jdennis011/haltech-gauges/README.md

# Haltech gauges

Round digital gauges for a car running a Haltech Nexus ECU. A hub listens to the
Haltech CAN broadcast, bridges the frames the gauges use to a private gauge bus
(`docs/frame-filter.md`), and hosts a web page for
setting the gauges up. One to three Waveshare ESP32-S3-Touch-AMOLED-1.75 gauges hang off
the hub on a daisy chain of 5 V and CAN, each on a small adapter board.

- Hub: ESP32-C6 (two CAN controllers plus Wi-Fi) on a carrier board. A Lolin C3 Mini runs
  the hub firmware for development, minus the ECU bridge.
- Gauge: the Waveshare board with an adapter that supplies power and CAN. An M5Stack Dial
  stands in on the bench.
- Faces are JSON configs: dials, rings, bars, numbers, labels, warning lights and shift
  rims, in a choice of fonts and themes. Fifteen starter templates are built in.
- The hub's page previews faces, pushes configs to gauges, and lets gauges be planned
  before the hardware exists. A visual designer is planned (`docs/designer-plan.md`).

## Building

PlatformIO with the pioarduino platform (installed on first build into its own core
directory, leaving a stock PlatformIO install alone).

```
pio run -e hub            # ESP32-C6 hub
pio run -e hub_dev_c3     # Lolin C3 Mini development hub
pio run -e gauge          # Waveshare gauge
pio run -e gauge_m5dial   # M5Stack Dial as a gauge
pio run -e wheel          # steering wheel module (Lolin C3 Mini)
pio test -e native        # host unit tests (scripts/test.ps1 finds a g++ on Windows)
node scripts/check_page.js # the hub page's script: syntax, and no function declared twice
.\scripts\release_fw.ps1  # publish hub builds on the site for updates over Wi-Fi
```

The hub's web page, templates and fonts are embedded into the firmware by
`scripts/embed_web.py` before each hub build.

## Online copy

**https://oagauge.online** (also at https://haltech-gauges.jdennis011.workers.dev)

The same page runs on Cloudflare without a hub, in demo mode: every template, font and
channel is there, previews animate, and what you make stays in your browser. Export a
config there and import it on your hub's page.

```
npm install          # once: wrangler
npm run build        # assembles ./dist from web/, assets/ and web/data/channels.json
npm run dev          # serves it at http://127.0.0.1:8787
npm run deploy       # publishes the Worker (wrangler login first)
```

`worker/index.js` serves the built files and answers the hub's data paths from static
files. It also handles **Sign in with Google** and keeps a signed-in user's configs,
planned gauges, assignments and recordings in a KV namespace, behind the hub's own API
paths, so work follows the account across devices. Signed out, the page keeps its work in
the browser.

To enable sign-in: in Google Cloud Console, APIs & Services, Credentials, create an
OAuth client ID of type Web application with the site's addresses as authorised
JavaScript origins (`https://oagauge.online`, `https://www.oagauge.online` and the `workers.dev` address); put the
client ID in `wrangler.jsonc` under `vars.GOOGLE_CLIENT_ID` and deploy. The session
secret is a Worker secret (`wrangler secret put SESSION_SECRET`), and local runs read it
from `.dev.vars`. `scripts/gen_channels.ps1` regenerates `web/data/channels.json` from the firmware's
channel tables; run it when `haltech_channels.def` or `units.cpp` change. Cloudflare's
Workers Builds can run `npm run build` and deploy on every push to `main`.

## Documents

| | |
|---|---|
| `docs/web-ui.md` | The hub's page and its REST and WebSocket API |
| `docs/config-schema.md` | The face config format |
| `docs/templates.md` | The built-in templates, with a gallery |
| `docs/alerts.md` | Alerts: rules on the hub that put a message on the gauges, or switch them to another config or face, when a channel meets a condition |
| `docs/images.md` | Images for the faces: kept on the hub, sent to each gauge once, over the gauge bus or, for big ones, the hub's Wi-Fi |
| `docs/cloud-sync.md` | Linking a hub to an account on the online copy, so configs, images, theme colours and alerts stay in step both ways |
| `docs/firmware-updates.md` | Firmware updates over Wi-Fi: a script that publishes builds on the site, the hub's check and install with rollback, a `.bin` upload from the page, and gauge builds passed on by the hub |
| `docs/gauge-adapter-handoff.md` | Hand-off for whoever takes on the gauge adapter: rev A as built, the rev B self-terminating design, open bench items |
| `docs/electrical-spec.md` | Hub carrier and gauge adapter: circuits, parts, connectors. Section 5 is a second hub design on a Waveshare ESP32-P4 board, with the clock and a GPS on the carrier |
| `docs/bom.md`, `docs/bom-jlcpcb.md` | Shopping lists by store, and the JLCPCB assembly order |
| `docs/bringup-checklist.md` | Bench steps in order, each with what to expect |
| `docs/designer-plan.md` | Plan for the online gauge designer and the `.gauge` file |
| `docs/ip-link.md` | A gauge on Wi-Fi instead of the CAN chain: the bus's frames over UDP, for the bench and the odd remote gauge |
| `docs/sd-card.md` | The P4 hub's microSD card and the datalog on it: every channel, ten times a second, a CSV per drive; formatting a card from the page |
| `docs/steering-wheel.md` | A steering wheel module on the gauge chain through the clock spring: its buttons by ADC, the horn relay with a fail-safe, the cruise buttons to the Nexus as FG Falcon frames on a third CAN bus, a wired-remote provision for the head unit |
| `docs/time-of-day.md` | The clock: NTP, the phone, a DS3231 on the carrier; the zone; the beacon field and the `clock` widget |
| `docs/startup-animation.md` | Key-on intro that runs across the gauges in order: the hub's trigger and settings, the order, the gauge's styles; the oaGauge boot splash shown while a gauge waits for it (`assets/splash/oagauge.svg`, made by `scripts/gen_splash.py`) |
| `docs/gauge-quick-menu.md` | Pull-down menu on the gauge for brightness, screen off and reset peaks, this one or all; the link icon (CAN or Wi-Fi) |
| `docs/frame-filter.md` | Each gauge tells the hub which Haltech frames its faces use; only those go on the gauge bus |
| `docs/motion.md` | The G meter from the gauge's own accelerometer, its mounting calibration, and the drag timer (0-100, the strip's splits, rolling runs), the built-in one every gauge shows on a pull up from the bottom edge, with its runs on the hub's page and SD card |
| `docs/gauge-audio.md` | The gauge speaker: the chime on Identify, the console tone and volume commands |
| `worker/`, `wrangler.jsonc`, `scripts/build_site.mjs` | The online copy on Cloudflare |
| `hardware/` | Schematics (Eagle XML, importable into EasyEDA; `hub-carrier-p4-rev-b.sch` is the next hub board) and the JLCPCB BOMs |

Haltech's CAN protocol document is not included; `docs/ref/README.md` says where to get it.

## Fonts

The eight bundled fonts are under the SIL Open Font License; each has its licence file
next to it in `assets/fonts`.
