jdennis011/haltech-gauges/docs/electrical-spec.md

# Electrical spec: hub carrier and gauge adapter

Draft for layout. Two items wait on bench results and are marked **[bench]**:
the gauge header pin order (bring-up step 1) and the 5 V budget (steps 1 and 4).

Section 1 is the hub as ordered, on an ESP32-C6 DevKit. Section 5 is a second hub
design on a Waveshare ESP32-P4 board, with the clock and a GPS on the carrier.

## 1. Hub carrier board

A carrier that the ESP32-C6-DevKitC-1-N8 plugs into, carrying the two CAN
transceivers, the protected 12 V input, the connectors and the mounting holes.
The DevKit has no mounting holes of its own, so the carrier is what gets screwed
into the enclosure.

### 1.1 DevKit footprint

Measured from Espressif's dimension drawing (`esp32-c6-devkitc-1-dimensions_v1.2.dxf`)
and layout PDF. Top view, USB ports at the bottom, antenna at the top:

```
                antenna overhang, ~6.35 mm past the board edge
             +-------------------------------------------+   <- top edge
   J1 pin 1  o   3V3                              G   o  J3 pin 1     1.575 mm from top edge
             o   RST                             TX   o
             o   4                               RX   o
             o   5                               15   o
             o   6                               23   o
             o   7                               22   o
             o   0                               21   o  J3-7   GPIO21  gauge-bus RXD
             o   1                               20   o  J3-8   GPIO20  gauge-bus TXD
             o   8  (RGB LED, strapping)         19   o  J3-9   GPIO19  ECU-bus RXD
             o   10                              18   o  J3-10  GPIO18  ECU-bus TXD
             o   11                               9   o
   J1-12     o   2   12 V sense ADC               G   o
             o   3                               13   o  (USB D+)
   J1-14     o   5V  carrier 5 V in              12   o  (USB D-)
   J1-15     o   G                                G   o
   J1-16     o   NC                              NC   o  J3-16               12.125 mm from bottom edge
             +-----[USB-C]---------[USB-C]---------------+   <- bottom edge
                   centre 5.5 mm     centre 19.9 mm from the left edge
             |<-------------- 25.4 mm ----------------->|
```

| Item | Value |
|---|---|
| DevKit outline | 25.4 x 51.8 mm, 0.5 mm corner radius; antenna adds ~6.35 mm past the top edge |
| Headers | 2 rows x 16 positions, 2.54 mm pitch |
| Row spacing | 22.86 mm centre to centre (0.9 in); each row 1.27 mm in from its board edge |
| Pin 1 | Antenna end, both rows; J1 is the left row, J3 the right row (top view, USB down) |
| Carrier holes | 1.0 mm drill, 1.8 mm pad, 32 positions (Espressif's own pads are 1.98 x 1.35 mm oblong) |
| USB-C ports | Both on the bottom edge; bodies reach about 8 mm up the board. Keep the enclosure open at that edge so the UART port can be reached without unplugging anything |
| Antenna keep-out | No copper on any layer under or within 10 mm of the antenna; easiest is to let the DevKit's top edge hang past the carrier's edge |
| Retention | Solder the DevKit's male headers straight into the carrier. Female headers alone will walk out with vibration; if you want it removable, add a printed clamp bar over the DevKit's bottom (USB) end |
| Height above carrier | About 8 mm with the DevKit soldered down; about 15 mm on female headers |

### 1.2 DevKit pins used

| DevKit pin | GPIO | Carrier connection |
|---|---|---|
| J1-1 | 3V3 | Supply for the gauge-bus transceiver, and the logic-level (VIO) pin of the ECU transceiver |
| J1-12 | GPIO2 (ADC1_CH2) | 12 V sense divider |
| J1-14 | 5V | Carrier 5 V rail, through D3 |
| J1-15, J3-1, J3-12, J3-15 | GND | Ground |
| J3-10 | GPIO18 | ECU transceiver TXD |
| J3-9 | GPIO19 | ECU transceiver RXD |
| J3-8 | GPIO20 | Gauge transceiver TXD |
| J3-7 | GPIO21 | Gauge transceiver RXD |
| J3-5 | GPIO23 | ECU transceiver S (silent) pin, with a 10 k pull-down so it is in normal mode by default. Driven high, the hub keeps listening to the Haltech bus but can neither transmit nor acknowledge |
| J1-2 | RST | Test point only |
| J1-5 | GPIO6 | I2C SDA for the real-time clock (rev B on the board; rev A as a wired module, section 1.8) |
| J1-6 | GPIO7 | I2C SCL for the real-time clock |

Do not use GPIO4, 5, 8, 9, 15 (strapping), 12/13 (USB) or 16/17 (UART console).

### 1.3 Power input (from the Haltech DTM-4)

```
DTM-4 pin 1 (+12 V switched) --F1--+--D1--+--D2--+--C1--+--[ U1 buck 12 -> 5.15 V ]--+-- 5 V rail
                                   |      |             |                            |
                                  TVS   reverse        bulk                         C2
                                   |    block           |
DTM-4 pin 2 (GND) -----------------+------+-------------+----------------------------+-- GND
DTM-4 pin 3 (CAN H) --> ECU transceiver
DTM-4 pin 4 (CAN L) --> ECU transceiver
```

| Ref | Part | Notes |
|---|---|---|
| F1 | 2 A fuse, ATO/mini blade holder or 2 A slow PTC | Resettable is fine at this current |
| D1 | SMBJ26CA bidirectional TVS | Clamps load dump; does not conduct on a 24 V jump start |
| D2 | Reverse-blocking Schottky, >= 3 A, >= 60 V (e.g. SS34, or a P-FET ideal-diode circuit for lower drop) | |
| C1 | 100 uF, 50 V electrolytic + 1 uF ceramic | Buck input |
| U1 | 5 V, 3 A buck, input rated to at least 40 V, minimum input 6 V or lower, output trimmed to 5.15 - 5.2 V | Module options: Pololu D36V28F5 (5.3-50 V in, 3.2 A; pins EN, VIN, GND, GND, VOUT left to right, see the 2026-10-27 note in bringup-checklist.md), or a TI TPS54360 / LMR33630 design. MP1584 (28 V) modules are not acceptable |
| C2 | 100 uF electrolytic + 10 uF ceramic | Buck output |
| D3 | Schottky, 1 A, from the 5 V rail to DevKit J1-14 | Stops a PC's USB feeding the carrier; the DevKit's own LDO makes 3.3 V |
| F2 | 2 A-hold polyfuse, 1812 (Littelfuse 1812L200/16DR, or /12DR), in the 5 V feed to the chain connector | A shorted chain cable takes out the fuse, not the buck |

Draw on the Haltech's switched 12 V (DTM-4 pin 1): three gauges at an estimated 0.3 A each
plus the hub is about 1.1 A at 5 V, so roughly 0.5 A at 13.8 V and up to about 1 A while the
battery sags during cranking. **[bench]** for the gauge current. The CAN +12 V supply must be
enabled in NSP, and if widebands or a dash share it, this adds to their total.

Why the buck's input range matters more than its current rating (the load is only about 1 A):

- **Upper limit.** D1 lets a transient reach about 42 V before it clamps fully. A module rated
  to 30 V (the DFRobot DFR1015 multi-output buck, 7.5-30 V, is the usual cheap option) would
  see more than its maximum. It can still be used if D1 becomes an SMBJ18CA, which clamps
  at about 29 V; the price is that a 24 V jump start blows F1.
- **Lower limit.** After D2's drop, a 7.5 V minimum means the 5 V rail collapses when the
  battery sags below about 8 V during cranking, and every gauge reboots. A 5.3 V minimum
  rides through.
- **Heat.** The DFR1015's protection is listed as acting at 70 C. Behind a dash in summer
  that is not much margin.

12 V sense: 100 k from +12 V (after F1, before D2) to GPIO2, 10 k from GPIO2 to GND, 100 nF across
the 10 k. 12 V reads about 1.09 V, 30 V about 2.7 V. The firmware logs it to show cranking dips.

### 1.4 CAN transceivers

Chosen from what JLCPCB stocks for assembly (it does not carry the TCAN3414 family). The
two buses get different parts because they face different hazards.

| Ref | Part | Notes |
|---|---|---|
| U2, ECU bus | NXP **TJA1051T/3** (SOIC-8) | The side wired into the car. Bus pins survive +/-58 V, TXD dominant time-out so a hung ESP32 cannot hold the Haltech bus dominant, automotive qualified. Needs 5 V on VCC (4.5-5.5 V, from the carrier's 5 V rail) and takes 3.3 V on VIO for the logic pins |
| | Pins: 1 TXD, 2 GND, 3 VCC (5 V), 4 RXD, 5 VIO (3V3), 6 CANL, 7 CANH, 8 S | S low = normal, S high = silent. GPIO23 with a 10 k pull-down. 100 nF at VCC and at VIO |
| U3, gauge bus | TI **SN65HVD230DR** (SOIC-8) | 3.3 V single supply, the same part as on every adapter and on the bench breakouts. Bus pins tolerate -4 to +16 V and there is no dominant time-out, which is acceptable on a private bus that only ever sees 5 V |
| | Pins: 1 D (TXD), 2 GND, 3 VCC (3V3), 4 R (RXD), 5 Vref (n/c), 6 CANL, 7 CANH, 8 RS | RS to GND selects high-speed mode, needed for 1 Mbit/s. 100 nF at VCC. 10 k pull-up from D to 3V3 keeps the bus recessive while the ESP32 is in reset |
| D4, D5 | PESD2CAN (SOT-23) across each CAN pair: pins 1 and 2 to the lines, pin 3 to GND | ESD on the connectors |
| L1 (optional) | Common-mode choke, 51 uH, on the ECU pair | Only if the car proves noisy |

If you would rather have the TCAN3414 on every node (3.3 V everywhere, +/-58 V everywhere),
it has to be bought from Mouser or DigiKey and hand-soldered or consigned; its STB pin must
be tied low and SHDN to ground.

Termination:

| Bus | Termination on the carrier |
|---|---|
| Gauge bus | Fixed split termination: 60 R + 60 R in series across H/L, 4.7 nF from the midpoint to GND. Each 60 R is two 120 R 1206 resistors in parallel, so the board uses one resistor value. The hub is one end of the chain; the terminator plug is the other |
| ECU bus | 120 R behind a 2-pin jumper, open by default. Nexus ECUs have selectable termination; with the car off, 60 R measured across H/L means the bus is already terminated at both ends and the jumper stays open |

### 1.5 Connectors

| Ref | Function | Part |
|---|---|---|
| J10 | ECU (12 V, GND, CAN H, CAN L) | 4-way Micro-Fit 3.0 2x2 on the board (Molex 43045-0412, vertical), to a home-made DTM-4 loom (section 1.6). **Rev A caution:** it is the same connector as J11 with the supply on pin 1, so a chain lead plugged in here by mistake puts 12 V into a gauge; label both. **Rev B:** the chain side moves to a 2x3 Micro-Fit for the self-terminating adapters (section 2.5) and J10 stays 2x2, so neither plug fits the other's header |
| J11 | Gauge chain out (5 V, GND, CAN H, CAN L) | 4-way Micro-Fit 3.0 2x2, same family as the adapters. Never use DTM-4 on the 5 V side, so the ECU's 12 V lead can never be plugged into a gauge |
| JP1 | ECU termination jumper | 2-pin 2.54 mm header |
| TP | GND, 5 V, 3V3, 12 V sense, RST | Test points |

Chain pin order (both hub J11 and every adapter): 1 = 5 V, 2 = GND, 3 = CAN H, 4 = CAN L. CAN H
and CAN L on a twisted pair; 20 AWG for 5 V and GND.

### 1.6 ECU loom (DTM-4 to the hub)

Made from a DTM kit, or, simpler, from a Haltech 4-core CAN cable (the user has one): keep the
end that mates with the ECU's CAN port or the CAN hub, cut the other off and crimp the Micro-Fit
on. Meter the cores against the DTM pin numbers moulded in the housing rather than trusting
colours. From a kit, build the gender that mates with the end it will plug into.

| DTM-4 pin | Haltech convention | Wire | Hub J10 pin |
|---|---|---|---|
| 1 | +12 V switched | 20 AWG red | 1 |
| 2 | Ground | 20 AWG black | 2 |
| 3 | CAN H | 22 AWG white, twisted with pin 4 | 3 |
| 4 | CAN L | 22 AWG blue, twisted with pin 3 | 4 |

- Size-20 solid contacts (DTM standard), wedge lock fitted, 500 mm is plenty.
- The pinout is Haltech's documented one for its CAN devices, not something in the broadcast
  protocol PDF. Before the first plug-in, confirm pin 1 is +12 V with the key on and pin 2 is
  ground. CAN H and L cannot be told apart with a meter at idle (both sit at about 2.5 V); if
  they are swapped nothing is damaged, the hub simply sees no frames, so swap and retry.
- The inline 2 A fuse goes in the red lead, close to the DTM end.

### 1.7 Board and mounting

- Suggested size about 70 x 50 mm, four M3 holes on a 60 x 40 mm pattern, 3.2 mm drill.
- The DevKit sits along one long edge with its antenna hanging past the board edge.
- The buck and the 12 V input stage go at the far end from the antenna; keep the switching
  node small and away from the CAN pairs.
- Connectors on one edge so the enclosure has a single cable face.
- All parts on the top side apart from the DevKit's header pins.

### 1.8 Real-time clock

The Haltech broadcast carries no time of day and neither ESP32 keeps time without power,
so the hub carries a battery-backed clock, sets it from the internet when it joins the
home network or from a phone's clock on the page, and sends the time to the gauges once
a second on the private bus.

**Rev A (the board as ordered):** a DS3231 breakout module wired in. Use the small
"DS3231 for Raspberry Pi" type with a CR2032 holder and no charger; it carries its own
pull-ups. VCC to the 3V3 test point, GND to the GND test point, SDA to GPIO6 and SCL to
GPIO7, soldered to the DevKit socket pins where they come through the carrier. For a
rechargeable cell, fit an ML2032 and charge it from 3V3 through a Schottky diode (BAT54)
and 1 k to the holder's positive terminal. Do not use the ZS-042 module: its charger
needs 5 V, and at 5 V the chip's data pins expect 3.5 V highs the C6 cannot give.

**Rev B (built in):**

| Ref | Part | Notes |
|---|---|---|
| U5 | DS3231SN (SOIC-16, +/-2 ppm) or DS3231M (SOIC-8, MEMS, +/-5 ppm, no crystal, cheaper and better stocked) | VCC from 3V3 with 100 nF; SDA, SCL to GPIO6, GPIO7 with 4.7 k pull-ups to 3V3; INT/SQW optional to a spare GPIO for a 1 Hz tick; 32K out unconnected |
| BT1 | ML2032 in a 2032 holder (rechargeable), or a CR2032 (5-10 years, no charger) | To VBAT with 100 nF. Charger for the ML2032: BAT54 from 3V3, 1 k in series, to the cell |
| alternative | 1 F to 5 F, 5.5 V supercapacitor on VBAT, charged through a diode from 3V3 | About a week of hold per farad; no cell to replace |

Time of day is then a `clock` widget on the faces; the hub keeps the time zone as a
setting.

## 2. Gauge adapter board

One per gauge. Plugs onto the gauge's rear 1x8 female header and carries the chain in and out.

### 2.1 Gauge header

1x8, 2.54 mm, female, on the back of the Waveshare board. Position 1 is the VBUS end.

| Position | Signal | Adapter use |
|---|---|---|
| 1 | VBUS (5 V in, same net as USB) | From chain 5 V through D1 |
| 2 | GND | GND |
| 3 | 3V3 | Transceiver supply |
| 4, 5 | GPIO43/44 (UART0) | Not connected. Order of these two is disputed and does not matter |
| 6 | GPIO16 | Transceiver D: the gauge's CAN transmit, `PIN_CAN_TX` |
| 7 | GPIO17 | Transceiver R: the gauge's CAN receive, `PIN_CAN_RX` |
| 8 | nothing found (GPIO18 expected) | Spare pad TP1, unused |

Measured on the gauge with a meter on 2026-10-29: position 6 is GPIO16, position 7 is GPIO17,
and nothing was found on position 8. Waveshare's hardware reference on GitHub has 6 and 7 the
other way round (6 = GPIO17, 7 = GPIO18, 8 = GPIO16); the firmware followed it until the first
chain test failed on exactly that. `PIN_CAN_TX 16` and `PIN_CAN_RX 17` in
`src/gauge/board_pins.h` match the board now.

### 2.2 Schematic

Drawn in `docs/gauge-adapter-schematic.svg`. The same circuit as a net list, for entering
into Fusion:

| Net | Connections |
|---|---|
| +5V_CHAIN | J1-1, J2-1, D1 anode |
| VBUS_D | D1 cathode, JP1-1 |
| VBUS | JP1-2, P1-1 |
| GND | J1-2, J2-2, P1-2, U1-2 (GND), U1-8 (RS), C1-2, D2-3 |
| +3V3 | P1-3, U1-3 (VCC), C1-1, R1-1 |
| CAN_TX | P1-6, U1-1 (D), R1-2 |
| CAN_RX | P1-7, U1-4 (R) |
| SPARE | P1-8, TP1 |
| CANH | J1-3, J2-3, U1-7, D2-1 |
| CANL | J1-4, J2-4, U1-6, D2-2 |

U1-5 (Vref) is left unconnected.
P1-4 and P1-5 (the gauge's UART0) are left unconnected. P1-6 is GPIO16 (`PIN_CAN_TX`) and
P1-7 is GPIO17 (`PIN_CAN_RX`), as measured in section 2.1.

### 2.3 Parts

| Ref | Part | Notes |
|---|---|---|
| J1, J2 | 4-way Micro-Fit 3.0 2x2, vertical (Molex 43045-0412), wired pin-for-pin in parallel | Chain in and chain out. Vertical means the cables leave straight back from the gauge, so the enclosure needs depth behind the adapter for the plug and the cable bend |
| P1 | 1x8 2.54 mm male header, mates with the gauge | |
| U1 | SN65HVD230DR (SOIC-8) | Powered from header position 3 (3V3). RS (pin 8) to GND for high-speed mode; Vref (pin 5) unconnected |
| C1 | 100 nF, within 2 mm of U1 pin 3 | |
| R1 | 10 k, D (pin 1) to 3V3 | Keeps the bus recessive while the gauge's ESP32 is in reset |
| D1 | Low-drop Schottky (<= 0.3 V at 0.5 A, e.g. SS14 or a PMEG series part), chain 5 V to header position 1 | Stops USB power reaching the chain when a gauge is plugged into a PC |
| JP1 | 2-pin jumper in series with D1 | Pull it to run a gauge from USB while it is still on the chain |
| D2 | PESD2CAN (SOT-23): pin 1 and pin 2 to the two bus lines, pin 3 to GND | Next to the connectors |
| TP1 | Test pad on the spare GPIO | |
| Holes | Three M2, matching the gauge's standoffs at (-13.75, +14.7), (+13.75, +14.7), (0, -20.5) mm from the display centre, +y towards the header | From Waveshare's STEP model; check against the board |

Termination: none on the adapter. The last adapter's J2 takes a terminator plug: a Micro-Fit
receptacle with 120 R between pins 3 and 4.

### 2.4 5 V budget **[bench]**

With a 5.15 V rail, 20 AWG wire, three gauges at roughly 0.3 A each and D1's drop, the last
gauge sees about 4.4 V. The AXP2101 runs down to 3.9 V and the firmware lowers its input
voltage limit to 4.04 V. Bring-up step 1 gives the real current and the lowest working voltage;
if the margin is thin, the fix is a lower-drop D1 (or a P-FET) before thicker wire.

### 2.5 Rev B: self-terminating adapter

Decided 2026-10-09. The rev B adapter finds out for itself whether it is the last gauge in the
chain and switches its own 120 R in, so there is no terminator plug and no port that has to be
the "out". It also closes the J10 mix-up (section 1.5) as a side effect.

**Connector.** The chain moves to a 6-way Micro-Fit 3.0 2x3 (header 43045-0612, housing
43025-0600, same 43030-0007 terminals). Pins 1 to 4 are unchanged (5 V, GND, CAN H, CAN L);
pins 5 and 6 are the presence pair. J10 on the hub stays the 2x2 of rev A, so neither plug fits
the other's header.

**Cable.** Still 4-core: pins 1 to 4 straight through as before. In every plug, pins 5 and 6
are shorted by a short loop of wire with a terminal on each end, hidden under the heat shrink.
Both ends get the loop, so the cable is still reversible.

**On every board.** Pin 6 of every port, hub J11 included, is ground. Pin 5 of each adapter
port is a sense line with a 4.7 k pull-up to 3V3. A plug in the port shorts 5 to 6 and pulls the
line low: "a cable is in this port". An empty port stays high. The loop draws 0.7 mA through
the pull-up, nothing more.

```
 port A pin 5 --+-- 4k7 -- 3V3         port B pin 5 --+-- 4k7 -- 3V3
                |                                     |
               BAT54 >|--+--------------------<|< BAT54
                          |
                          +-- 100k -- GND
                          |
                          +-- IN of U2 (TS5A3166, V+ = chain 5 V)
                          +-- spare GPIO (TP1), 3.3 V logic: "I am the end of the chain"

 CAN H --- U2 (COM/NO, Ron 1 R) --- 120 R --- CAN L
```

- Either port empty (high) turns U2 on: the last gauge, or a gauge alone on the bench, is
  terminated. Both ports occupied (middle gauge): off. Both empty: on, once, which is
  harmless.
- U2 is an SPST analogue switch with a 0 to V+ signal range; powered from the chain 5 V it
  covers CAN H's 1.5 to 3.5 V with margin. Its 1 R and about 10 pF are nothing beside the
  120 R. Pinout in SOT-23-5: 1 NO, 2 GND, 3 IN, 4 COM, 5 V+.
- Levels: the 4.7 k pull-up, the BAT54's drop and R4's 100 k put the enable node at about
  2.9 V when a port is empty, against the TS5A3166's 2.4 V threshold at a 5 V supply (with
  10 k pull-ups it would be 2.7 V, too close). R4 stays at 100 k: a higher value lets the
  switch's input leakage lift the "off" level. The SN74LVC1G66 is not a substitute here: at
  5 V its threshold is 0.7 x Vcc, about 3.5 V, which this node cannot reach.
- No split capacitor on the adapter: a plain 120 R, since the hub's termination carries the
  common-mode cap.
- **Caveat:** the sense is of the plug, not of what is on its far end. A lead plugged into the
  last gauge with nothing on its other end reads "connected", so that gauge does not terminate
  and the lead hangs off the bus as an unterminated stub. In the car every lead is in at both
  ends or removed; on the bench, unplug an unused lead at the gauge. (Sensing the far board
  instead would need a 6-core cable with pins 5 and 6 crossed over; the plug loop was chosen
  to keep 4-core cable.)
- The spare GPIO reads the same node, so the gauge can tell the hub it is the end of the chain;
  the hub can then warn if two gauges say so (a chain plugged in wrongly) or none does. Hub
  J11 pin 5 can go to a hub GPIO with a pull-up the same way, to show whether a chain is
  plugged in at all. Neither is needed for the termination to work.
- Parts, with manufacturer numbers: `docs/bom-jlcpcb.md`, "Gauge adapter, rev B".

## 3. JLCPCB assembly

JLCPCB places the surface-mount parts; the through-hole parts (Micro-Fit headers, pin
headers, the Pololu module and the DevKit) are hand-soldered afterwards. LCSC numbers were
checked against JLCPCB's catalogue on 1 October 2026; "basic" parts carry no per-part
loading fee, "extended" parts cost a few dollars each per order.

### 3.1 Gauge adapter (per board)

| Ref | Part | Package | LCSC | Class |
|---|---|---|---|---|
| U1 | SN65HVD230DR | SOIC-8 | C12084 | extended |
| D2 | PESD2CAN,215 | SOT-23 | C75176 | extended |
| D1 | SS14 | SMA | C2480 | basic |
| C1 | 100 nF 50 V X7R | 0805 | C49678 | basic |
| R1 | 10 k 1% | 0805 | C17414 | basic |

Hand-soldered: J1, J2 (Molex 43045-0412), P1 (1x8 male header), JP1 (1x2 header).

### 3.2 Hub carrier

| Ref | Part | Package | LCSC | Class |
|---|---|---|---|---|
| U2 | TJA1051T/3/1J | SOIC-8 | C38695 | extended |
| U3 | SN65HVD230DR | SOIC-8 | C12084 | extended |
| D4, D5 | PESD2CAN,215 | SOT-23 | C75176 | extended |
| D1 | SMBJ26CA-E3/52 (Vishay) | SMB | C515606 | extended |
| F2 | 1812L200/16DR (Littelfuse) | 1812 | C439873 | extended |
| C (bulk) x2 | 100 uF 50 V, Nichicon UUD1H101MNL1GS | SMD 8 x 10 mm | C116241 | extended |
| D2 | SS34 | SMA | C8678 | basic |
| D3 | SS14 | SMA | C2480 | basic |
| R x5 | 120 R 1% (four for the split termination, one behind the ECU jumper) | 1206 | C17909 | basic |
| R x3 | 10 k 1% (S pull-down, sense divider, U3 pull-up) | 0805 | C17414 | basic |
| R x1 | 100 k 1% (sense divider) | 0805 | C149504 | basic |
| C x4 | 100 nF 50 V X7R | 0805 | C49678 | basic |
| C x1 | 1 uF 50 V X7R (buck input) | 0805 | C28323 | basic |
| C x1 | 4.7 nF 50 V X7R (split termination) | 0805 | C1744 | basic |
| C x2 | 10 uF 25 V (5 V rail) | 0805 | C15850 | basic |

Hand-soldered: J10, J11 (Molex 43045-0412), JP1 (1x2 header), the Pololu D36V28F5 and the
ESP32-C6 DevKit.

The store-by-store shopping list is in `docs/bom.md`.
For the JLCPCB assembly order (its BOM layout, LCSC numbers, what to upload) see `docs/bom-jlcpcb.md`.

## 4. Schematic files for EasyEDA

`hardware/gauge-adapter.sch`, `hardware/hub-carrier.sch` and `hardware/hub-carrier-p4.sch`
(section 5) are Eagle 7 XML schematics, generated by `scripts/gen_eagle_sch.py` from the
net lists in this document. Import them in EasyEDA
with File > Import > Eagle. Every pin has a short wire and a net label; pins sharing a
label are connected.

- Each surface-mount part carries an `LCSC` attribute with its part number. In EasyEDA,
  set that as the part's supplier number and take the footprint from the LCSC library.
- The footprints inside the files are generic land patterns, there so pin numbers survive
  the import. Do not lay out on them as they are.
- The ESP32-C6-DevKitC-1 footprint is dimensionally correct (from Espressif's drawing), and
  so are the Waveshare ESP32-P4-WIFI6's pins and outline (from Waveshare's drawing) and the
  Adafruit Ultimate GPS socket and its standoff holes (from Adafruit's board file).
- The Micro-Fit footprint follows Molex sales drawing SD-43045-005 for the vertical
  43045-0412: four 1.02 mm holes on a 3.00 mm square, circuits 1 and 2 along one row with
  3 and 4 opposite, two 1.02 mm polarising peg holes 9.00 mm apart and 0.94 mm outside the
  3-4 row, body 9.65 x 7.37 mm, 9.9 mm tall. Check it against the current drawing before
  ordering boards.
- The right-angle 43045-0400 (drawing SD-43045-001) shares the same four pin holes but
  uses one 3.00 mm snap-in peg hole on the centreline, 4.32 mm from the nearer pin row, and
  its body is 12.2 mm deep. Swapping between them only moves the retention holes.
- The Pololu footprint is a placeholder: replace it with Pololu's drill guide for the
  D36V28Fx.
- Diodes use pad 1 = cathode and the polarised capacitors pad 1 = positive. Check both
  against the footprint EasyEDA assigns.

To change a circuit, edit the part and net lists in the script and run it again.

## 5. Hub carrier, ESP32-P4 variant

A second hub design on a **Waveshare ESP32-P4-WIFI6** (SKU 32020) in place of the
ESP32-C6 DevKit. The P4 has three CAN controllers, two fast cores and 32 MB of RAM, and the
board adds an ESP32-C6 for Wi-Fi, already wired and loaded with its firmware, so the carrier
needs no radio of its own. The carrier adds the real-time clock and a socket for an
Adafruit Ultimate GPS with an external antenna. The 12 V input, the 5 V rail, both CAN
transceivers, the terminations and the two Micro-Fit connectors are the C6 carrier's
(sections 1.3 to 1.6), with the same reference designators.

Schematic: `hardware/hub-carrier-p4.sch`, drawn out in `docs/hub-carrier-p4-schematic.svg`.
Rev A was built as one board and first powered on 2026-10-27 (`docs/bringup-checklist.md`:
the Pololu socket's library footprint had VIN and VOUT swapped and took the first P4); the
`hub_p4` firmware build runs on the Waveshare board. Rev B, with the fixes and the steering
wheel outputs, is `hardware/hub-carrier-p4-rev-b.sch` (section 6.3). The first version of this design, on an Olimex ESP32-P4-DevKit with a Wi-Fi
module on the carrier, is in the git history (commit 4ca940c).

| | C6 carrier (section 1) | P4 carrier |
|---|---|---|
| Processor board | ESP32-C6-DevKitC-1, 25.4 x 51.8 mm | Waveshare ESP32-P4-WIFI6, 21 x 71 mm, Raspberry Pi Pico pin pattern |
| CAN controllers | 2 (both used) | 3 (two used, one spare) |
| Wi-Fi | In the C6 | An ESP32-C6 module on the Waveshare board |
| Clock | Wired-in module (rev A) | U5 DS3231 and a 2032 cell on the carrier |
| GPS | None | Adafruit Ultimate GPS in J12, with an external active antenna |
| 5 V into the board | DevKit 5V pin, through D3 | VSYS pin, through D3 |
| Also on the board | | microSD slot, speaker amplifier and microphone, USB 2.0 high-speed port, 32 MB flash |

### 5.1 The board

Pin pattern and outline from Waveshare's dimension drawing, pin functions from its
schematic, holes from its layout print.

```
               USB-C end
          +------------------------------------+
  pin 1   o  GPIO52                  VBUS      o  pin 40   never connect
          o  GPIO51                  VSYS      o  39       5 V in, through D3
          o  GND                     GND       o  38
          o  GPIO31  clock 1 Hz      3V3_EN    o  37       leave open
          o  GPIO30  GPS PPS         3V3       o  36       carrier 3.3 V
          o  GPIO29  GPS data out    GPIO20    o  35       12 V sense
          o  GPIO28  GPS data in     GPIO21    o  34       ECU TXD
          o  GND                     GND       o  33
          o  GPIO50  GPS off         GPIO22    o  32       ECU RXD
          o  GPIO49                  GPIO23    o  31       ECU S
          o  GPIO5                   RUN       o  30       reset test point
          o  GPIO4                   GPIO26    o  29
          o  GND                     GND       o  28
          o  GPIO3                   GPIO27    o  27
          o  GPIO2                   GPIO32    o  26       gauge TXD
          o  GPIO8   I2C SCL         GPIO33    o  25       gauge RXD
          o  GPIO7   I2C SDA         GPIO46    o  24
          o  GND                     GND       o  23
          o  GPIO24  USB D-          GPIO47    o  22
  pin 20  o  GPIO25  USB D+          GPIO48    o  21
          |      ESP32-C6 Wi-Fi module,        |
          |      antenna over a notch          |
          +----------+              +----------+
```

| Item | Value |
|---|---|
| Outline | 21.00 x 71.05 mm. USB-C at one end. The last 18 mm at the other end hold the ESP32-C6 module, whose antenna sits over a 13.8 x 5.2 mm notch in the board's end |
| Pins | 2 x 20 at 2.54 mm, the rows 17.78 mm apart and 1.61 mm in from the long edges: the Raspberry Pi Pico pattern, so any Pico footprint fits the pins. Pins 1 and 40 are 4.52 mm from the USB end; pins 20 and 21 are 18.27 mm from the far end. The edge pads are castellated and drilled |
| Holes | Four of about 1.7 mm, measured from Waveshare's layout print to about 0.1 mm: 1.37 mm in from the long edges, 1.45 mm and 55.6 mm from the USB end. They are on the footprint's documentation layer only: check them against a board before drilling for them |
| Underside | The P4, the microSD slot, the audio chips and the 2-pin speaker plug are on the underside, so the board can't lie flat on its edge pads. Two 1 x 20 sockets (8.5 mm tall) clear all of it. Soldered straight in on the 2.5 mm headers Waveshare supplies, the speaker plug needs a cut-out in the carrier |
| Retention | On sockets, hold the board down with a strap or a printed clamp in the enclosure; sockets alone work loose with vibration |
| Antenna | No copper under the far end: let the last 20 mm hang past the carrier's edge, and keep the GPS and the buck at least 15 mm from it |
| On the board | ESP32-P4 (chip revision 3, section 5.8) with 32 MB flash, ESP32-C6-MINI-1 Wi-Fi with a PCB antenna, microSD slot, ES8311 audio codec with a speaker amplifier and microphone, USB-C through a USB-serial chip with automatic reset for programming, a 4-pin header for reflashing the C6, MIPI display and camera connectors, and a 3.3 V buck regulator marked 3 A |
| I2C | GPIO7 (SDA) and GPIO8 (SCL) are the board's own bus, shared with its audio codec (address 0x18) and the display and camera connectors, with 2.2 k pull-ups to 3.3 V. The clock joins it at 0x68 |

### 5.2 Power

| Board pin | Net | Notes |
|---|---|---|
| 39 VSYS | +5V_MCU | From the carrier's 5 V rail through D3 (SS14) |
| 36 3V3 | +3V3 | The board's 3.3 V regulator. It supplies the ECU transceiver's logic side, the gauge-bus transceiver, the clock and the pull-ups |
| 40 VBUS | none | The USB-C port's own 5 V. Never connect it |
| 37 3V3_EN | none | Pulled up on the board; pulled low, it turns the 3.3 V regulator off |
| 30 RUN | RST | The P4's reset, to test point TP5 |

On the board, USB power reaches VSYS through an ideal-diode circuit (a P-channel FET
switched by a pair of PNP transistors) that stops current flowing from VSYS back into the
USB port, so feeding VSYS never pushes the car's supply into a PC. Nothing on the board
stops current the other way: with USB plugged in and the car off, a PC would feed VSYS, and
through it the carrier's 5 V rail, the ECU transceiver, the GPS and the whole gauge chain.
D3 blocks that, as it does on the C6 carrier.

- On the car's supply, everything runs.
- On USB alone, the board runs with its Wi-Fi, and so do the clock and the gauge-bus
  transceiver; the carrier's 5 V side (the ECU transceiver, the GPS and the gauge chain)
  stays off.

D3 drops about 0.3 V, leaving about 4.8 V at VSYS, ample for the board's 3.3 V regulator.

### 5.3 Board pins used

| Board pin | GPIO | Carrier connection |
|---|---|---|
| 35 | GPIO20 (ADC1 channel 4) | 12 V sense divider |
| 34 | GPIO21 | ECU transceiver TXD |
| 32 | GPIO22 | ECU transceiver RXD |
| 31 | GPIO23 | ECU transceiver S (silent), 10 k pull-down |
| 26 | GPIO32 | Gauge transceiver TXD, 10 k pull-up |
| 25 | GPIO33 | Gauge transceiver RXD |
| 17 | GPIO7 | I2C SDA, clock |
| 16 | GPIO8 | I2C SCL, clock |
| 4 | GPIO31 | Clock INT/SQW (1 Hz tick or alarm), 10 k pull-up |
| 7 | GPIO28 | GPS data in: the GPS's TX, through 1 k |
| 6 | GPIO29 | GPS data out: the GPS's RX |
| 5 | GPIO30 | GPS PPS, through 1 k |
| 9 | GPIO50 | GPS off: high turns the GPS off through Q1 |
| 39, 36, 30 | VSYS, 3V3, RUN | Section 5.2 |
| 3, 8, 13, 18, 23, 28, 33, 38 | GND | Ground |

- **Spare:** GPIO2 to 5, GPIO26, GPIO27, GPIO49, GPIO51 and GPIO52; enough for a third CAN
  bus.
- **Avoid GPIO46 to 48** (pins 24, 22 and 21): they run from the microSD slot's supply, which
  the P4 switches itself and which is off until the firmware turns it on. Pins 19 and 20 are
  the P4's full-speed USB port.
- **Taken on the board and not on the header:** GPIO14 to 19, GPIO54 and GPIO6 (Wi-Fi),
  GPIO9 to 13 and GPIO53 (audio), GPIO39 to 45 (microSD), GPIO34 to 38 (strapping pins, the
  BOOT button and the USB-serial chip), GPIO0 and GPIO1 (32 kHz crystal).

### 5.4 Wi-Fi

- The ESP32-C6-MINI-1 on the board runs Espressif's ESP-Hosted firmware and appears to the
  P4 as an ordinary Wi-Fi interface over SDIO, on the same pins Espressif's own P4 board
  uses. The hub's access point, the home-network connection and the web page work as on the
  C6 hub.
- It ships with its firmware loaded, but the P4 side of ESP-Hosted has to match the version
  on the C6. There is an open report of a Waveshare P4 board whose factory C6 firmware would
  not talk to Arduino-ESP32 3.3.11 (waveshareteam/ESP32-P4-WIFI6-Touch-LCD-5, issue 13). If
  that happens here, reflash the C6 through the 4-pin header beside it (IO9, GND, RXD, TXD):
  short IO9 to GND, connect a 3.3 V USB-serial adapter (its TX to RXD, its RX to TXD), hold
  the board's BOOT button while powering up so the P4 leaves the C6 alone, and flash. After
  that, ESP-Hosted can update the C6 over the SDIO link.
- Inside the case, keep the GPS at least 15 mm from the board's antenna end. The GPS antenna
  itself is outside the case.

### 5.5 Clock

The P4 has a clock of its own and the board fits its 32 kHz crystal, but nothing on the
board keeps it powered after key-off. The carrier's DS3231 carries the time; with a GPS fix,
the hub also sets it from the satellites.

| Ref | Part | Notes |
|---|---|---|
| U5 | DS3231SN# (SO-16 wide, +/-2 ppm) | VCC 3.3 V with C14 100 nF. SDA and SCL to GPIO7 and GPIO8, on the board's own pull-ups. Pins 5 to 12 have no function and are grounded, as the datasheet requires. RST and 32KHZ unconnected |
| R20 | 10 k | Pull-up on INT/SQW, which goes to GPIO31 for a 1 Hz tick |
| BT1 | 2032 holder | CR2032 (5 to 10 years), or a rechargeable ML2032 |
| C15 | 100 nF | On the cell |
| D6, R21, JP2 | BAT54, 1 k, 2-pin jumper | Trickle charge from 3.3 V for an ML2032: about 3.0 V at the cell, under 1 mA. **JP2 is fitted only with an ML2032. A CR2032 must never be charged: leave JP2 open** |

### 5.6 GPS

An **Adafruit Ultimate GPS** (product 746) plugs into J12 and uses an **external active
antenna**: GPS signals barely reach a box behind the dash.

| J12 pin | GPS pin | Connection |
|---|---|---|
| 1 | PPS | Through R23 1 k to GPIO30: one pulse a second once it has a fix |
| 2 | VIN | Carrier 5 V, with C16 10 uF at the socket. The GPS board makes its own clean 3.3 V from it |
| 3 | GND | |
| 4 | RX | From GPIO29. 5 V tolerant on the GPS side; the P4 drives it at 3.3 V |
| 5 | TX | Through R22 1 k to GPIO28; a 3.3 V signal |
| 6 | FIX | Not connected (the GPS board's own fix LED) |
| 7 | VBAT | Not connected: the GPS board has its own CR1220 holder |
| 8 | EN | Drain of Q1 (2N7002). GPIO50 high turns Q1 on, pulls EN low and turns the GPS off |
| 9 | 3.3V | Not connected |

- **Why Q1:** the GPS board pulls EN up to VIN, 5 V, through 10 k, and a P4 pin must never
  see 5 V. R24 (100 k) holds Q1's gate low, so the GPS is on unless the hub turns it off,
  including while the P4 is in reset. Turning it off and on again restarts a GPS that has
  stopped answering.
- **Mounting:** J12 is a 1 x 9 socket (Sullins PPTC091LFBN-RC, 8.5 mm). Solder the header
  supplied with the GPS to its underside, pins down, and plug it in component side up. The
  GPS board is 25.4 x 34.3 mm and lies over the carrier; its two 2.5 mm holes are 29.72 mm
  from the header row, in line with pins 1 and 9. The footprint has 2.7 mm holes there for
  M2.5 standoffs about 11 mm tall (the socket plus the header's plastic). Keep parts under it
  below about 8 mm.
- **Backup cell:** the CR1220 holder is on the GPS board's underside. Fit a CR1220: it keeps
  the GPS's almanac and clock, so it gets a fix within seconds of key-on instead of about half
  a minute.
- **Antenna socket:** the GPS's u.FL socket is at its far end, near the hole above pin 1.
  Place J12 so that end faces the case wall that carries the SMA socket.

The antenna:

| Part | Notes |
|---|---|
| Adafruit 851 | 15 cm lead from u.FL to an SMA socket (female) that bolts through the case wall. Plug the u.FL end in once and tie the lead down: u.FL is rated for about 30 matings, and a pull on the antenna cable should land on the case, not the GPS board |
| Adafruit 960 | Active antenna, 3 to 5 V, 28 dB, 5 m lead, SMA plug, magnetic base, IP66. Any active GPS antenna that runs on 3 V and has an SMA plug will do. Not RP-SMA: Wi-Fi antennas often use it, it looks almost the same, and it does not mate with SMA |

- The GPS powers the antenna through the coax and switches to it by itself when one is
  plugged in. A passive antenna is not used.
- The roof is best (the magnetic base needs a steel roof), with the cable in through a door
  or boot seal. Hidden is fine under plastic or glass, never under metal: on the dash top
  under the windscreen, under the rear shelf, or inside a plastic spoiler. Heat-reflecting
  windscreens block GPS except at a clear patch near the mirror.

### 5.7 Parts

The C6 carrier's list (section 3.2) less the C6 DevKit, plus:

| Ref | Part | Package | LCSC | Class |
|---|---|---|---|---|
| U5 | DS3231SN#T&R | SO-16 wide | C9866 | extended |
| D6 | BAT54 | SOT-23 | C8590 | extended |
| Q1 | 2N7002 | SOT-23 | C8545 | basic |
| R20 | 10 k 1% (four in all with R1, R2, R9) | 0805 | C17414 | basic |
| R24 | 100 k 1% (two in all with R8) | 0805 | C149504 | basic |
| R21, R22, R23 | 1 k 1% | 0805 | C17513 | basic |
| C16 | 10 uF 25 V (three in all with C4, C5) | 0805 | C15850 | basic |
| C14, C15 | 100 nF 50 V X7R (six in all with C6, C7, C8, C10) | 0805 | C49678 | basic |

Hand-soldered: J10, J11 (Molex 43045-0412), J12 (Sullins PPTC091LFBN-RC), JP1, JP2 (1 x 2
headers), BT1 (2032 holder), the Pololu D36V28F5, and two 1 x 20 sockets for the Waveshare
board (Sullins PPTC201LFBN-RC).

Bought separately:

| Item | Where | Price |
|---|---|---|
| Waveshare ESP32-P4-WIFI6, SKU 32020. The version with the headers already fitted plugs straight into the sockets | Waveshare | $13.99 |
| Adafruit Ultimate GPS, product 746 | Core Electronics, or Adafruit | US$29.95 |
| Adafruit 851, u.FL to SMA panel lead | Core Electronics, or Adafruit | US$3.95 |
| Adafruit 960 active GPS antenna, or any active GPS antenna with an SMA plug that runs on 3 V | Adafruit | US$21.50 |
| M2.5 standoffs, about 11 mm, and screws, two | Anywhere | |
| CR1220 for the GPS, CR2032 or ML2032 for the clock | Anywhere | |

Q1's LCSC number was checked on 5 October 2026; the rest are the C6 carrier's or the first
version's, checked the same week. `hardware/jlcpcb/hub-carrier-p4-bom.csv` is the board's
list in JLCPCB's layout; the table in `docs/bom-jlcpcb.md` has the manufacturer numbers.

### 5.8 What is not done

- **Firmware.** The hub firmware builds for the C6 and for the C3 stand-in only. A P4 build
  needs the two CAN ports on GPIO21/22 and GPIO32/33, Wi-Fi through ESP-Hosted
  (Arduino-ESP32's defaults match this board), the clock on I2C, a GPS reader, and GPIO50 for
  the GPS's power. The CAN library used on the C6 also has to be confirmed on the P4.
- **Chip revision.** This board's P4 is the newer revision 3 (ESP32-P4NRW32X). Firmware has to
  be built for it: Arduino-ESP32 3.3.11 or later with the chip variant set to revision 3 (the
  toolchain here is 3.3.12). Builds for revision 1 do not run on it.
- **Wi-Fi firmware match:** section 5.4.
- **Bench checks before the layout is frozen:** that D3 and the board's ideal diode behave as
  described with USB plugged in; the height under the board on its sockets; the hole
  positions; the GPS's reception from the chosen antenna spot.
- **Footprints.** The Waveshare board's pins and outline and the GPS's pins and holes are from
  the makers' files. The cell holder's and the Pololu's are placeholders.

## 6. Steering wheel module and the hub's outputs for it

The module and wiring for `docs/steering-wheel.md` (2026-10-26, designed, not yet built).

### 6.1 Wheel module board

Perfboard first, a PCB once the wheel's ladders are measured.

| Ref | Part | Notes |
|---|---|---|
| MCU | Lolin C3 Mini (ESP32-C3) | CAN TX GPIO4, RX GPIO5; ladder lines GPIO0, 1, 3 (and 2); LED GPIO7; BOOT GPIO9. Its own LDO makes 3.3 V from the 5 V pin and needs more than about 3.5 V; the chain delivers at least 4.4 V at the last node (2.4) |
| U1 | SN65HVD230 (SOIC-8) | From the board's 3V3; RS to GND; 10 k pull-up on D; 100 nF |
| R_T | 120 R 1 % across CAN H and L | Fitted: this node is always the chain's end |
| D2 | PESD2CAN | On the pair, next to the pigtail |
| D1 | SS14 | Chain 5 V to the board's 5 V pin, so USB on the bench cannot feed the chain |
| JP1 | 2-pin jumper in series with D1 | Pull it to run the module from USB while still plugged into the chain, as on the gauge adapter |
| C1, C2 | 100 µF electrolytic, 10 µF ceramic | At the 5 V pin: a Wi-Fi fetch draws up to 300 mA for a few seconds |
| R_L1-3 | 2.2 k | Pull-up from each ladder line to 3V3; change the value if two buttons land within 100 mV of each other |
| R_S1-3, C_S1-3 | 1 k series into the ADC pin, 100 nF to GND | Filtering; the line runs to buttons under hands |
| D3-5 | PESD5V0 | One per ladder line |
| J1 | 4-way pigtail (JST-XH or soldered) | To the clock spring's wheel-side connector: 1 = 5 V, 2 = GND, 3 = CAN H, 4 = CAN L |

### 6.2 Clock spring

The four conductors carry the chain's pin order, 1 = 5 V, 2 = GND, 3 = CAN H, 4 = CAN L.
Put H and L on adjacent conductors and 5 V and GND on the other two. The ribbon is not a
twisted pair: after fitting, watch the gauge bus error counters on the Settings tab for ten
minutes with the wheel plugged in and the wheel turned lock to lock. The old horn wire at
the column connector becomes the relay's switched line (6.3). With rev A adapters the
module replaces the terminator plug on the last adapter's J2; with rev B adapters the plug
into the last adapter carries the pin 5-6 loop so that adapter's 120 R switches out.

### 6.3 Hub carrier rev B (P4)

Schematic: `hardware/hub-carrier-p4-rev-b.sch`, generated by `scripts/gen_eagle_sch.py`
(96 parts, 60 nets); the BOM in JLCPCB's layout is `hardware/jlcpcb/hub-carrier-p4-rev-b-bom.csv`
and the manufacturer numbers are in `docs/bom-jlcpcb.md`. Rev B is rev A as built (section 5,
with the ML2032 charger: U6 XC6206P302MR at 3.0 V, D6 BAS70, R21 1 k, JP2) plus the rows below.
Designators continue rev A's, so U6 stays the charger and the vehicle CAN transceiver is U7.

| Ref | Part | Notes |
|---|---|---|
| J11 | Micro-Fit 3.0 2x3 (43045-0612) | The rev B chain connector (section 2.5): 1 +5 V, 2 GND, 3 CAN H, 4 CAN L, 5 sense, 6 GND |
| R44 | 4.7 k | Pull-up from 3V3 to J11 pin 5; the line goes to GPIO51 and reads low while a chain plug is in. Not read by the firmware yet |
| U7 | TJA1051T/3 | Vehicle CAN transceiver on GPIO26 (TX) and GPIO27 (RX); S on GPIO52 with R45 10 k pull-down (high = listen only); C20, C23 decoupling |
| JP3, R46 | 120 R | Fitted: a two-node bus with the Rebel |
| D7 | PESD2CAN | On the vehicle CAN pair |
| J14 | "VEHICLE CAN" Micro-Fit 3.0 2x3 (43045-0612, decided 2026-10-27) | 1 = NC, 2 = GND, 3 = CAN H, 4 = CAN L, 5 = NC, 6 = GND. Pins 2 to 4 sit where the chain puts them, so one crimping convention serves both looms. No supply pin and nothing on pin 5, so a chain plug put here by mistake does nothing, and its 5-6 loop only shorts NC to ground. A vehicle CAN cable (GND, H, L, no loop) in a chain port leaves that adapter's sense line high and its termination in. J10, the only 12 V socket, stays the 2x2 that neither cable fits |
| J15 | 1x3 header: 5 V, GND, IN | For an opto-isolated relay module set to low-level trigger |
| Q2 | AO3400A | Pulls the module's IN low. A logic-level FET, because the pump below gives it about 2 V of gate drive |
| C21, D8, C22, R47 | 1 uF, BAT54S, 10 uF, 4.7 k | The pulsed drive: GPIO49's 1 kHz square wave through C21 is clamped to ground by one half of D8 and rectified into C22 by the other; R47 bleeds C22 in about 50 ms, so a stuck level, a reset or a hung task drops the relay. Firmware flag `HG_HORN_PULSED` |
| R48 | 100 k | GPIO49 to ground, so the pin rests low |
| JP4, R49 | jumper, 1 k | "HORN DIRECT": fitted, GPIO49 drives Q2's gate as a level through R49 (firmware without `HG_HORN_PULSED`); open with the pulsed firmware |
| Relay contact | NO, between the column horn wire and GND | The JZA80 horn button grounds the horn relay's coil (about 150 mA); the car's own horn fuse stays |
| J13 | 1x6 header: GND, REM, SW1-SW4 | Wired remote for the head unit |
| Q3-Q6, R50-R53 | 2N7002, 100 k | From GPIO2, 3, 4, 5, each switching R30-R33 to REM; the 100 k hold the gates low in reset |
| R30-R33 | Through-hole, unfitted | Values from the head unit's manual once it is chosen; SW1-SW4 on J13 expose the same points for external resistors |
| U8, C24 | MCP4531T-103E/MS (DNP) | A 10 k digital pot on the board's I2C (A0 low, address 0x2E) as the alternative; wiper to REM |
| Q7, Q8, U9, R40-R43, C19, TP6 | AO3401A, MMBT3906, TL431, 10 k, 2.2 k, 15 k, 10 k, 100 nF | The over-voltage cutoff, below |
| R8 | 150 k | 12 V sense divider top, as built on rev A (with R9 10 k the factor is 16; the firmware does not read the pin yet) |

**Over-voltage cutoff.** The buck's output is its own net, +5V_RAW. Q7, a P-channel MOSFET
with its source on +5V_RAW and its drain on the +5V rail, carries everything downstream: the
board through D3, the chain through F2, the transceivers, the GPS and the relay header. R40
holds Q7's gate low, so it is on. U9 compares +5V_RAW through R42 and R43 (15 k over 10 k)
with its 2.495 V reference: above 6.24 V it conducts, R41 pulls Q8's base down, Q8 lifts Q7's
gate to its source and Q7 opens. Q7's body diode points from the rail back to the buck, so
nothing passes while it is off. The first P4 died on 2026-10-27 from 12 V reaching VSYS
through a wrong module footprint; with this in place the same fault stops at Q7, and so does
a buck whose switch has failed short. Drop through Q7: about 70 mV at 1.5 A. TP6 is the
buck's output, for checking the module before the board is fitted.

### 6.4 Horn safety

- Off until **Horn** is enabled on the page; off at reset and brown-out by the pull-down.
- Released within 100 ms of the wheel's reports stopping, whatever the cause.
- The pulsed drive and the task watchdog cover a hung hub.
- A page test is a pulse of at most two seconds.
- The contact is in series with the car's own horn relay, so a stuck contact means
  "horn on", not an electrical hazard.
