jdennis011/haltech-gauges/docs/gauge-quick-menu.md

# Gauge pull-down menu

Swipe down from the top edge of any gauge and a small panel slides over the face:

```
   +------------------------------+
   |  Brightness  [=======----]   |
   |  [ Screen off ] [ Reset peaks ]|
   |  [ Set level ] [ Set forward ] |
   |  Apply to    ( this ) ( all )|
   +------------------------------+
```

- **Brightness**: a slider, live as it moves. The gauge keeps its own brightness in
  flash, so it survives a restart.
- **Screen off**: the panel goes dark and the gauge stops rendering. Any touch, or the
  hub, brings it back. Not remembered across a restart: at key-on the screen comes on.
- **Reset peaks**: clears every held peak and minimum on the faces (widgets with `hold`,
  `docs/config-schema.md`): the tell-tale needles and marks go, and a number showing its
  held value shows the live one again until a new peak arrives.
- **Set level** and **Set forward** (boards with an accelerometer): the two captures
  that tell the G meter and drag timer which way is up and forward (`docs/motion.md`):
  the first with the car at rest, the second while braking firmly on a straight road.
  The result shows at the bottom of the face for a moment. Reset peaks also clears the
  G meter's marks and the drag timer's results.
- **Apply to**: *this gauge* changes only the one you are touching. *All gauges* sends
  the change to the hub, which applies it to every gauge on the bus and remembers the
  brightness, so a gauge that reconnects gets it too.
- **Link icon**, top right: which link the live data is arriving on, a plug for the CAN
  chain or a Wi-Fi fan for the IP link (docs/ip-link.md), with its name; "no data" when
  neither has brought a Haltech frame in the last second. CAN wins when both are up.
  The same icon appears near the top of the face for three seconds whenever the link
  changes, including the first data after power-on, so a gauge that silently falls
  back from the chain to Wi-Fi says so.
- The panel closes with a swipe up, a tap outside it, or by itself after five seconds.
- **Drag timer**: a pull up from the bottom edge of the face (with the panel closed)
  shows the built-in drag timer over the face, swipes left and right pick the run type,
  and a swipe up brings the face back (`docs/motion.md`, "The overlay").
- Night dimming from the headlight signal still applies on top of the chosen brightness.

## What is already in place

- Protocol: `Cmd::SetDisplay` (0 off, 1 on) alongside `SetBrightness`, `Cmd::ResetHold`
  (the hub relays it to every gauge for an "all" request, and the page can send it:
  `POST /api/gauges/{node}/reset_holds`, `/api/gauges/all/reset_holds`, the card's and
  the All gauges strip's **Reset peaks**), and a gauge-to-hub
  **Request** message, `{cmd, arg, all}`, sent with `GaugeNode::request()`. The hub
  answers "all" requests by commanding every online gauge and remembering brightness.
- Hub: `display_control` keeps the all-gauges brightness in preferences and the
  screens-off state in RAM, re-applies both to any gauge that comes online, and
  exposes them on the page and the API: `POST /api/gauges/all/brightness {level}`,
  `POST /api/gauges/all/display {on}`, `POST /api/gauges/{node}/display {on}`, with
  the state in `/api/status` as `displays`.
- Page: an **All gauges** strip on the Gauges tab with a brightness slider and screens
  off/on, and screen off/on per card.

## On the gauge

`src/gauge/quick_menu.cpp` is the panel: an LVGL container that a swipe down opens
over the face (swipes left and right still change faces), with the slider (10 to 255,
applied live, saved to flash on release), **Screen off**, and **this** / **all**. With
*all*, the change also goes to the hub as a `Request`, which applies it to every gauge
and remembers the brightness. It closes on a swipe up, a tap on the face outside it, or
five seconds after the last touch. A dark screen is not drawn, and the first touch on it
only wakes it; a `SetDisplay` from the hub wakes it too. The gauge's own brightness is
read from flash at start and after a hub command.

The link icon is `src/gauge/link_icon.cpp`, drawn with LVGL arcs and rectangles (no image,
nothing to rasterise); `can_task::liveLink()` decides which link from the time of the
last Haltech frame off the wire and off the IP link.
