jdennis011/haltech-gauges/docs/web-ui.md

# Hub web UI

The hub runs a Wi-Fi access point and serves a single page from its firmware.
Nothing is installed on the phone or PC.

## Reaching it

1. Join the Wi-Fi network **HaltechGauges**, password **haltech123** (both set in
   `src/hub/hub_config.h`).
2. Open **http://192.168.4.1/**. Any address typed into the browser lands there too.

To use it from a PC on your home network instead, give the hub your network's
details once, either in the page's **Settings** tab or on the serial console
with `W<network>;<password>`. The hub then also joins that network, keeps the
access point running, and the serial console (`w`) and the Settings tab show the
address it was given.

## Tabs

| Tab | What it does |
|---|---|
| Gauges | A **Theme colours** section, folded away until opened, changes a shared theme colour from a dropdown and a colour wheel (with brightness and a hex box); the previews follow as the wheel moves, and the hub passes the colour to the gauges. One card per gauge, real or planned, with a live preview of the config it is assigned, drawn at the face it is on, with the message and face of any alert in force. Real gauges show online state, MAC, firmware, supply voltage, and buttons for identify, face change, brightness, screen off and on, and reboot, and for a gauge with a speaker a volume slider and a beep. An **All gauges** strip sets brightness for every gauge (remembered by the hub and applied to any gauge that connects) and turns every screen off or on. The assignment dropdown is the "desired state": the hub pushes that config whenever the gauge's stored one differs. A **Runs** card appears once a gauge's drag timer has reported a run (`docs/motion.md`): the latest fifty, newest first, with the gauge, the run, the time and the splits; **Clear** forgets them. |
| Live data | Every Haltech channel with its current value, updated three times a second. Data comes from the ECU bus (C6 hub) or from the simulator. The **Simulator** card pauses the values, runs them slower or faster (0.1x to 4x), and holds any channel at a value or sweeps it between limits of your own, which is how a face is laid out against a particular reading. **Presets** on the same card keep a named set of speed and overrides on the hub (16 at most): **Save as…** stores what is in force, **Load** brings a preset back, **Delete** removes it, **Download** writes the selected preset (or the settings in force) as a file, and **Import file** loads such a file, from this hub or another. |
| Alerts | Rules the hub checks against the live data ten times a second: when a channel goes above or below a value, leaves or enters a range, a status flag comes on or goes off, or a reading changes, the gauges show a message, switch to a face, or both, and go back when it ends. Each row shows whether the alert is in force and the current reading, and **Test** fires it for five seconds. `docs/alerts.md` has the details. |
| Configs | The **Images** card is the hub's library of pictures for the faces (`docs/images.md`): **Add image** shrinks the file you pick to a size you choose (up to the 466 px face), encodes it as JPEG, or PNG where there is transparency, and shows the file size and roughly how long it takes to reach each gauge before you save it; each image shows its size, which configs use it, and buttons to download or delete it. In the editor an **image** widget shows one in a box, and the **Face background** row above the widget list sets the face's colour and a background picture with its opacity. The **Theme colours** card holds the hub's shared colours, each with a name: eight to start with, and **Add colour** adds more up to 32 (only the last one can be removed, so the numbers never shift). Widgets use them from their colour lists (or as `themecolour1`, `themecolour2` and so on in the JSON), and changing one recolours every widget that uses it, on every gauge. The library of stored configs. Start from a template (`docs/templates.md` describes the fifteen built in) or import a file, **Export all** to save every stored config, the images, the planned gauges, the assignments, the alerts, the simulator's settings and its presets as one file, and **Import all** to restore such a file on this or another hub (configs of the same name are replaced; planned gauges are matched by MAC, or by name when not linked to hardware), edit the JSON with a live preview of the selected face, **Validate** (runs the gauge's own parser on the hub), **Save**, **Download**, and **Try on gauge**, which shows a config on a gauge without storing it. Widgets can be dragged on the preview to move them; a click selects one (dashed outline, highlighted in the panel below), arrow keys nudge it by a pixel or ten with shift, and positions snap to the face centre. While a widget is dragged, guides appear and snap its centre to the face centre and to other widgets' centres, horizontally and vertically. The four corner handles resize: the radius of a dial, ring or rim, the width and height of a bar, the text size of a number or label, the size of a light, the width and height of a shape (a polygon's corners scale), the size of a path. The knob above the selection rotates a text, number, light or bar widget about its position, turns the start angle of a dial or ring, or swings an arched label round its circle, snapping to 15 degree steps. A label follows a circle when its Arc radius is set. **Add widget** puts a new dial, ring, bar, number, label, light, rim, shape or path (a vector icon from SVG path data) on the face with sensible defaults, selected and ready to drag; each row has a remove button. A shape is a rectangle, ellipse, line, triangle or polygon; a path draws any icon from its SVG path data, with a few to pick from (engine, warning, battery, thermometer, arrow, circle, star). Either is plain decoration, or, given a channel under All options, lit while its condition holds and dimmed or hidden otherwise, which makes a path a warning icon. The rows are the draw order, later rows on top; drag a row by its title, or use the up and down arrows on it, to reorder them. Shift + click selects more than one widget (Ctrl+A every widget on the face): they drag and nudge together, Delete removes them, Ctrl+D duplicates them, and Same x, Same y, Spread x and Spread y line them up. Undo and Redo (Ctrl+Z, Ctrl+Y) cover every change, typed JSON included; a Zoom choice enlarges the preview; the ? button lists the keys; and what is typed is kept in the browser until saved, offered back when the config is reopened. Under the preview, **Widget styles** lists the widgets on the selected face, each with pickers for its channel, unit and range, its text, colours (a theme role or a custom colour), rotation, text alignment, whether and where a number shows its unit, and its font and size, plus an **All options** section listing every other setting the format accepts for that widget, with dropdowns for the choices and small editors for zones and warning thresholds, so changing what a face shows needs no JSON editing (one dropdown also sets every font in the config), and **Fonts on the hub** shows each bundled family drawn with the gauge's own font file. |
| Settings | Hub, access point and home-network details; memory and bus counters. The **Online account** card links the hub to an account on oagauge.online with a six-character code from the site's own Settings page, after which configs, images, theme colours and alerts made on either side reach the other (`docs/cloud-sync.md`); it shows the account, the link's state and the last sync, with **Sync now** and **Unlink**. On the online copy the same tab has a **Hubs** card instead: the account's linked hubs with when each last checked in, **Link a hub** to make a code, and **Unlink**. |

### Planned gauges

**Add a planned gauge** creates a gauge on the hub before the hardware exists,
so configs can be assigned and faces laid out on the bench or with no gauge at
all. A planned gauge has a name, a synthetic MAC (`02:00:00:00:00:<id>`, an
address no real board can have), an assigned config and a chosen face, and its
card previews that face with live or simulated data. Up to eight are kept in
`/virtual.json` on the hub's filesystem, so they survive a restart.

**Link to hardware…** enters the MAC of the real gauge (shown on its serial
banner and on its own card once it has announced itself). The name and the
config assignment move to that MAC, and from then on the real gauge's card
carries the planned name. Until the hardware is seen, the card says "waiting
for" that MAC. **Rename** on a real gauge's card does the same thing in one
step. **Unlink** forgets the name but leaves the assignment in place.

### Recordings

The **Recordings** card on the Live data tab records the live channel values (from the
ECU, or from the simulator on the bench) ten times a second for 30 seconds to 3
minutes, keeping only the values that changed, so a minute of driving is a hundred or
two kilobytes on the hub's filesystem. Play a recording and the simulator carries it
to every gauge on the bus and to the previews, following the simulator's pause and
speed, looping if asked; the simulator's overrides still apply on top. Download a
recording to keep it, to open it in the online copy (Upload recording there, then
Play), or to upload it to another hub. The **Library** row lists base recordings
published with the site (`assets/recordings` in the repo): the online copy plays them
directly, and a hub's page copies one onto the hub and plays it. Signed in to the
online copy, your own recordings and the simulator's speed, overrides and presets are kept in
your account. A recording is JSON, one row per line:

```
{"kind":"haltech-gauges-recording","schema":1,"name":"highway","rate_hz":10,"channels":["rpm",...],"rows":[
[0,[0,2850,1,101.3,...]],
[100,[0,2862]],
...
[59900,[]]
],"duration_ms":60000}
```

Each row is the time in milliseconds and index-value pairs for the channels that
changed, indexes into the header's channel list.

The **simulator** chip at the top right makes the hub generate the full Haltech
broadcast with moving values, for testing without the car. With a gauge on the
bus it also sends the frames to the gauge. Frames keep going out while it is paused,
so gauges hold the frozen values. Up to 16 channels can be overridden at once.

## Development board

On the Lolin C3 Mini build (`hub_dev_c3`) everything above works except the ECU
bridge: the header chip says "no ECU bridge (dev board)" and the Live data tab
only has values while the simulator is on.

## REST API

All responses are JSON. Errors are `{"ok":false,"error":"..."}` with a 4xx status.

| Method and path | Purpose |
|---|---|
| GET `/api/status` | Hub state: uptime, memory, bus counters, simulator, Wi-Fi |
| GET `/api/gauges` | Roster, real gauges first then planned ones (`"virtual":true`, node `V<id>`) |
| POST `/api/gauges/{node}/identify` `{"seconds":5}` | Gauge shows its id |
| POST `/api/gauges/{node}/face` `{"index":0}` | Switch face |
| POST `/api/gauges/{node}/brightness` `{"level":200}` | 10-255 |
| POST `/api/gauges/{node}/volume` `{"level":60}` | Speaker volume 0-100; the gauge keeps it. The roster's `volume` is what a gauge with a speaker reports |
| POST `/api/gauges/{node}/sound` `{"sound":"beep"}` | `beep`, `chime`, `alarm` or `riff` on its speaker |
| POST `/api/gauges/{node}/display` `{"on":false}` | Screen off or on |
| POST `/api/gauges/{node}/reset_holds` | Clears its held peaks and minimums (widgets with `hold`) |
| POST `/api/gauges/all/brightness` `{"level":200}` | Every gauge; remembered and re-applied to newcomers |
| POST `/api/gauges/all/display` `{"on":false}` | Every screen off or on (not kept across a hub restart) |
| POST `/api/gauges/all/identify` | |
| POST `/api/gauges/all/volume` `{"level":60}` | Every gauge with a speaker |
| POST `/api/gauges/all/sound` `{"sound":"beep"}` | |
| POST `/api/gauges/all/reset_holds` | Every gauge's held peaks and minimums |
| POST `/api/gauges/{node}/reboot` | |
| POST `/api/gauges/{node}/try` (body: a config) | Show without storing |
| POST `/api/gauges/{node}/endtry` | Back to the stored config |
| GET `/api/runs`, DELETE `/api/runs` | The drag timer runs the gauges reported, newest first; or forget them (`docs/motion.md`) |
| GET `/api/channels/meta` | Every channel with its unit and the unit conversions |
| GET `/api/channels` | Current live values |
| GET `/api/configs` | Stored configs: name, size, crc, title, faces, and the images each uses |
| GET / PUT / DELETE `/api/configs/{name}` | Read, store (validated) or delete one |
| POST `/api/validate` (body: a config) | Parser verdict without storing |
| GET `/api/assignments` | `{"AA:BB:CC:DD:EE:FF":"name"}` |
| PUT `/api/assignments/{mac}` `{"name":"x"}` | Assign; empty name clears |
| GET `/api/templates`, GET `/api/templates/{name}` | Built-in starter configs |
| GET `/api/fonts` | Bundled font families: `key`, `family`, `style` (from `assets/fonts/fonts.json`) |
| GET `/api/virtual` | Planned gauges: id, label, mac, face |
| POST `/api/virtual` `{"label":"x","mac":"…"}` | Add one; `mac` optional, else synthetic. Returns `{"ok":true,"id":n}` |
| PUT `/api/virtual/{id}` `{"label","face","mac"}` | Change any of the three; `"mac":""` goes back to synthetic |
| DELETE `/api/virtual/{id}` | Remove; clears a synthetic-MAC assignment |
| GET `/api/recordings` | `[{name, bytes, duration_ms, recording}]` |
| GET / PUT / DELETE `/api/recordings/{name}` | Download, upload (the file as the body, up to 1 MB, streamed to the filesystem) or delete one |
| POST `/api/record` `{"action":"start","name":"x","seconds":60}` or `{"action":"stop"}` | Returns the recorder's state, also in `/api/status` as `recording` |
| POST `/api/playback` `{"action":"start","name":"x","loop":true}` or `{"action":"stop"}` | Returns the playback state, also in `/api/status` as `playback` |
| GET `/api/simulator` | `{enabled, paused, speed, overrides:[{channel, hold} or {channel, min, max}]}` |
| POST `/api/simulator` | Any of `enabled`, `paused`, `speed` (0.05-10), `clear`, and `overrides` as `{"rpm": {"hold": 3000}, "coolant_temp": {"min": 80, "max": 110}, "gear": null}` (or as a list of `{channel, hold}` / `{channel, min, max}`); values in the channel's stored unit. Returns the settings. On, paused, speed and the overrides are kept in the hub's preferences and come back after a restart |
| GET `/api/simulator/presets` | The saved presets: `[{name, speed, paused, overrides:[...]}]`, up to 16, kept on the hub's filesystem |
| PUT `/api/simulator/presets/{name}` | Save `{speed, paused, overrides}` under the name, or the settings in force with an empty body; a preset of the same name is replaced |
| POST `/api/simulator/presets/{name}/apply` | Apply it (clears the overrides first); returns the settings |
| DELETE `/api/simulator/presets/{name}` | |
| GET `/api/images` | `{images:[{name, size, crc, width, height, type}], free, total, max_bytes, max_count}` |
| GET / PUT / DELETE `/api/images/{name}` | Download, upload (the JPEG or PNG as the body, up to 256 KB and 466 x 466, streamed to the filesystem and checked) or delete one |
| GET `/api/theme-colours` | `{colours:[{value:"#FFFFFF", name:"White"}, ...]}`, 8 to 32 of them |
| PUT `/api/theme-colours` (body: 8 to 32 `{value, name}`) | Replaces them; the gauges get them within a second |
| GET `/api/alerts` | `{rules, states:[{active, count, value}], max}`; the rule format is in `docs/alerts.md` |
| PUT `/api/alerts` (body: the list of rules) | Replaces every alert; refused as a whole, naming the rule, if one is wrong |
| POST `/api/alerts/test` `{"index":0,"seconds":5}` | Puts one alert in force for a while |
| GET / PUT / DELETE `/api/wifi` | Home-network credentials `{"ssid","password"}` |
| GET `/api/cloud` | The link to the online account: `{url, hub_id, name, linked, email, state, error, last_sync_s, rev, pending}`; also in `/api/status` as `cloud` |
| POST `/api/cloud/link` `{"code":"ABC234"}`, `/api/cloud/unlink`, `/api/cloud/sync` | Link with a code from the site, unlink, sync now; each answers with the state (`docs/cloud-sync.md`) |
| (in `/api/status`) `ip_bus` | Gauges linked over Wi-Fi: `{port, peers: [{ip, node, age_s}], rx_frames, tx_packets, dropped}` (`docs/ip-link.md`); each gauge in `/api/gauges` has `link`: `can` or `wifi` |
| GET `/api/sd`, POST `/api/sd/mount`, POST `/api/sd/logging` `{"on": false}`, GET/DELETE `/api/sd/logs/{name}` | The SD card and the datalog on it (`docs/sd-card.md`); `sd` and `datalog` are also in `/api/status` |
| GET `/api/time`, PUT `/api/time` `{"unix": n}` or `{"tz": "AEST-10", "tz_name": "Australia/Brisbane"}` | The hub's clock and zone: set from the page's device, or the zone (`docs/time-of-day.md`) |
| GET `/api/intro`, PUT `/api/intro` `{enabled, style, stagger, duration}`, POST `/api/intro/play` | The key-on intro's settings, and playing it now (`docs/startup-animation.md`) |
| GET `/api/gauge-firmware`, POST `/api/gauge-firmware/check`, `/fetch` `{"board": 1}`, `/remove` `{"board": 1}` | The gauge builds the hub keeps: check the site, fetch one onto the hub, remove one (`docs/firmware-updates.md`, "Gauges") |
| POST `/api/gauges/{node}/update` | Sends that gauge the hub's build for its board over Wi-Fi |
| GET `/gauge/image/{crc}?token=…`, GET `/gauge/firmware?token=…` | What a gauge fetches over the hub's Wi-Fi, with the token the hub gave it (`docs/images.md`, "Over Wi-Fi") |
| GET `/api/update` | Firmware: this build, the latest on the site, the state and progress; also in `/api/status` as `update` (`docs/firmware-updates.md`) |
| POST `/api/update/check`, `/api/update/install` | Check the site now; install the build the last check found |
| PUT `/api/update` (body: a `firmware.bin`) | Flash an uploaded hub image into the spare app slot and restart |

`/ws` is a WebSocket that pushes `{"t":"status"}` once a second,
`{"t":"gauges"}` on change, `{"t":"live","v":{...}}` three times a second, and
`{"t":"alerts","states":[...]}` when an alert fires or ends, and
`{"t":"themeColours","colours":[...]}` when the theme colours change.
A push is skipped when a client has not drained the previous ones or free memory
is below 40 KB; `ws_skipped` in the status counts those.

`#live`, `#alerts`, `#configs` and `#settings` on the page's address open that tab directly.

## Memory

The ESP32-C3 has about 140 KB free with Wi-Fi up, and a failed allocation
restarts the firmware (the status shows `"reset":"panic"` afterwards). The
server therefore streams the 21 KB channel list and stored configs rather than
buffering them, keeps the WebSocket queue short, answers 503 to large requests
when memory is short (browsers retry), refuses to parse a config when memory is
tight, and the page fetches the five fonts only when the editor opens. Under a
deliberately heavy test (a browser loading the page while six downloads run,
repeated four times with four WebSocket clients open) the lowest free heap was
34 KB. Two or three browsers on the page at once is fine; a dozen is not what
it is for.

## Working on the page

`web/index.html` is the whole UI. Open it straight from disk in a browser and
it runs against built-in mock data, so layout work needs no hub.
`scripts/shot_page.mjs` screenshots it that way in headless Chrome at a chosen
viewport (`#gauges-demo` and `#configs-demo` on the address fill in demo data).
The look is the stylesheet at the top of the page: design tokens in `:root`
(colours, radii, control height, fonts), then a section per part of the page. The
script builds its markup from a fixed set of ids and class names, so restyle in
the stylesheet rather than renaming those. On phones the tabs move to a bar along
the bottom and the status pills scroll sideways in the header. The build
script gzips it into `src/hub/web_assets.h` (about 14 KB) along with the
templates in `assets/templates/` and the fonts in `assets/fonts/`.

## Wheel card

With a steering wheel module on the chain (docs/steering-wheel.md), the Gauges tab shows a
**Wheel** card instead of a gauge card for it: online state and firmware with **Update
firmware**, the buttons as pills lit while held with when each last changed, a fault
banner, the **Outputs** toggles (Horn, Cruise over CAN, Volume), **Tests** (a timed pulse
of an output; the horn behind a confirm), **Calibration** (a raw stream from the wheel,
Capture per button, Save pushes the table to the wheel) and the **FG bus** table with its
capture log, Listen only and Probe. Its API is `/api/wheel` (the module's document lists
the routes); the WebSocket message is `{"t":"wheel",...}`.
