jdennis011/haltech-gauges/docs/config-schema.md

# Gauge config format (schema 1)

A config is one JSON document, at most 32 KB, holding a theme and up to 8
faces. A face is a list of up to 16 widgets drawn in order. The gauge swipes
between faces. The parser is `lib/hg_config/face_parse.cpp`; anything it
rejects comes back with the location, for example
`faces[1].widgets[2]: unknown channel 'boost'`. Unknown keys are ignored, so
newer configs still load on older firmware as long as `schema` matches.

```json
{
  "schema": 1,
  "name": "Street",
  "theme": "white",
  "faces": [
    {
      "name": "Boost",
      "widgets": [
        { "type": "dial", "channel": "manifold_pressure", "unit": "psi_gauge",
          "min": -15, "max": 30, "major": 9,
          "zones": [ { "from": 22, "to": 30, "color": "alert" } ] },
        { "type": "number", "channel": "manifold_pressure", "unit": "psi_gauge",
          "y": 330, "font": "digital", "size": 64, "decimals": 1,
          "warn": { "above": 25, "flash": true } },
        { "type": "label", "text": "BOOST", "y": 140, "size": 28, "color": "dim" }
      ]
    }
  ]
}
```

## Conventions

- **Geometry** is in pixels on the 466 x 466 round panel, origin top-left. `x`, `y` are the
  widget's centre and default to the middle of the screen (233, 233).
- **Angles** are degrees, 0 at 3 o'clock, clockwise. A classic dial is `start` 135, `sweep` 270.
- **Colours** are `#RRGGBB`, `#RGB`, a theme role (`bg`, `fg`, `accent`, `dim`, `warn`, `alert`),
  or one of the hub's theme colours, `themecolour1` to `themecolour32` (below).
- **Channels** are the names in `lib/hg_haltech/haltech_channels.def` (`rpm`, `oil_pressure`,
  `coolant_temp`, ...).
- **Units** are optional. Without one the channel's native unit is used. `min`, `max`, zones and
  thresholds are all in the chosen unit.

| Channel kind | `unit` values |
|---|---|
| Gauge pressure | `kPa`, `psi`, `bar` |
| Absolute pressure (manifold, baro) | `kPa`, `psi`, `bar`, and relative to atmosphere: `kPa_gauge`, `psi_gauge`, `bar_gauge` |
| Temperature | `C`, `F` |
| Speed | `km/h`, `mph` |
| Lambda | `lambda`, `afr` |
| Acceleration | `m/s2`, `g` |
| Volume | `L`, `gal` |

- **Fonts**: `sans` (Fira Sans), `condensed` (Barlow Condensed), `digital` (DSEG7, 7-segment),
  `mono` (Share Tech Mono), `display` (Russo One), `carter` (Carter One), `racing` (Racing Sans One),
  `trade` (Trade Winds). Characters a family lacks are drawn in `sans`.
  The hub's editor lists them, drawn with the real files, and offers them per widget.
- **Theme**: a preset name (`white`, `red`, `amber`, `green`, `cyan`, `nfs`) or an object giving any of the six
  roles as hex colours or theme colours.

### Theme colours

The hub keeps colours of its own, shared by every config and every gauge: always at least
eight, by default 1 white, 2 orange, 3 red, 4 yellow, 5 green, 6 blue, 7 grey and 8 black,
and up to 32 with the ones you add. Each has a name of up to 16 characters. Colours are
added and removed only at the end, so a number always means the same colour; a number the
hub does not have (a removed colour, or a config from another hub) is drawn white. A config
uses them as `themecolour1` to `themecolour32` (the
US spelling `themecolor1` also works) anywhere a colour goes: a widget's `color`,
`needleColor`, `trackColor`, `offColor` or `strokeColor`, a zone or warn colour, a face's
`bg`, or a role in the config's own theme object, so that `"theme": {"fg": "themecolour1"}`
puts every widget in its default colour onto hub colour 1.

Change a theme colour on the hub (the Theme colours card on the Configs tab, or
`PUT /api/theme-colours`) and every widget that uses it changes with it, on every face of
every gauge, without pushing any config again. A config's own theme roles stay per
config; theme colours are the way to share a colour across configs.

The gauges get the colours over the bus (message `ThemeColours`, type 7: sixteen frames,
each the frame number then two colours as 3-byte RGB, so all 32 slots with the unused
ones white) when they change, when a gauge comes online, and every 10 seconds. A gauge keeps the last ones in flash, so it shows the same
colours when running without a hub.

## Top level and faces

| Key | Required | Notes |
|---|---|---|
| `schema` | yes | `1` |
| `name` | | up to 32 characters |
| `theme` | | preset name or colour object; default `white` |
| `faces` | yes | 1 to 8 faces |
| face `name` | | |
| face `bg` | | default: the theme's `bg` |
| face `bgImage` | | an image from the hub's library, filling the face behind the widgets (`docs/images.md`) |
| face `bgImageOpacity` | | 0 to 100 (100); below 100 the `bg` colour shows through |
| face `widgets` | yes | 1 to 16 widgets |

A config uses at most 16 different images. `images` at the top level is not part of a config:
the hub adds it on the way to a gauge (each image's CRC32, `{"logo": "1A2B3C4D"}`) and refuses a
config that already has one.

## Widgets

Every widget takes `type`, `x`, `y`, `color` (default `fg`). Every widget except `label`,
`clock`, `gmeter` and `dragtimer` needs `channel` and may take `unit`; for `shape`, `path` and `image` the channel is optional. Every widget except
`light`, `shape`, `path` and `image` may take
`warn: { "above": n }` or `{ "below": n }` with optional `color` (default `alert`) and `flash`,
which recolours it past the threshold.

| Type | Keys (default) |
|---|---|
| `dial` | `min`, `max` (required); `r` outer radius (220); `start` (135), `sweep` (270); `major` divisions (10), `minor` subdivisions (5); `tickLen` (16), `tickWidth` (3), `ticks` (true; false leaves only the labels), `tickShape`: `line`, `triangle` (`line`), `arcWidth` (0; a thin arc along the sweep where the ticks start); `labels` (true), `labelFont` (`sans`), `labelSize` (22), `labelScale` (1; use 1000 for RPM x1000); `needle`: `line`, `tapered`, `tapered_cap`, `none`, `marker` (`tapered`; `none` makes a labelled scale to pair with a ring; `marker` is an arrow with its base on radius `r` pointing inward at the value, `marker_out` one with its tip on `r` pointing outward, both `needleLen` long (28) and `needleWidth` half as wide at the base, for a set point or target); `needleColor` (`accent`), `needleWidth` (6), `needleLen` (r - 24); `zones`, `zoneWidth` (6); `hold`: `none`, `max`, `min` (`none`; a thin tell-tale needle stays at the highest or lowest value seen until Reset peaks on the gauge), `holdColor` (the needle colour), `holdSeconds` (0; a peak older than this rolls back to the live value, 0 keeps it until Reset peaks) |
| `ring` | `min`, `max` (required); `r` (225), `thickness` (20); `start`, `sweep`; `rounded` (true); `track` (true), `trackColor` (`dim`); `segments` (0 = solid), `gap` degrees (3); `zones`; `hold`, `holdColor` (as the dial: a line across the arc at the value held; default the widget colour), `holdSeconds` |
| `bar` | `min`, `max` (required); `style`: `horizontal`, `vertical`; `w`, `h` (260 x 28, swapped when vertical); `track`, `trackColor`; `segments`, `gap` pixels (3); `cornerRadius` (4); `rotate` (0; degrees clockwise about the centre); `zones`; `hold`, `holdColor` (a line across the bar at the value held), `holdSeconds` |
| `number` | `font` (`sans`), `size` (72), `decimals` (0); `rotate` (0; degrees clockwise); `format`: `plain`, `gear` (`plain`; `gear` shows N, R, P or the gear number); `pad` (0; minimum digits, zero-filled, e.g. 3 for `000`); `showUnit` (true), `unitSize` (size / 3), `unitPos`: `below`, `right`, `left`, `above` (`below`), `unitDx`, `unitDy` (0; nudge the unit from that position, pixels); `align`; `hold`: `none`, `max`, `min` (`none`; shows the held value in place of the live one until Reset peaks on the gauge; live readings only, never the demo sweep), `holdSeconds` (0; the held value rolls back to the live one after this many seconds) |
| `label` | `text` (required, up to 32 characters); `font`, `size` (24), `align`; `rotate` (0; degrees clockwise); `arc` (0; radius of a circle centred on `x`, `y` that the text follows, so 0 is straight text), `arcAngle` (270; where the middle of the text sits, degrees clockwise from 3 o'clock, so 270 is the top), `arcSide`: `auto`, `inside`, `outside` (`auto` faces the letters outward on the top half and inward on the bottom, so both read left to right) |
| `light` | `r` half size (14); `shape`: `dot`, `ring`, `square`, `text` (shows `text` alone, only while lit); `rotate` (0); `color` when lit (`alert`), `offColor` (`dim`); `on`: `{ "above": n }` or `{ "below": n }` (default above 0.5, i.e. a status flag is set); `flash`; `text` caption |
| `rim` | `from` (required); `mode`: `flash` (whole rim lights from `from` upward) or `fill` (fills between `from` and `to`, `to` required); `r` (233), `thickness` (12); `color` (`alert`) |
| `shape` | `shape`: `rect`, `ellipse`, `line`, `triangle`, `polygon` (`rect`); `w`, `h` (100 x 60; a line's length is `w`); `cornerRadius` (0); `filled` (true), `color` fill, `strokeColor`, `strokeWidth` (0, or 3 when not filled), `opacity` (100), `rotate` (0); a polygon takes `points`, 3 to 16 x, y pairs relative to `x`, `y`. `channel` is optional: with one, the shape is drawn in `color` while `on` holds (as for a light) and in `offColor` otherwise, or not at all with `hideWhenOff`; `flash` |
| `path` | `d` (required): SVG path data, up to 1024 characters, as copied from an icon's `<path d="...">`; `box` (24), the size of the path's own coordinate square; `size` (48), how large to draw it; `filled`, `color`, `strokeColor`, `strokeWidth`, `opacity`, `rotate`, and the optional `channel`, `on`, `offColor`, `hideWhenOff`, `flash` as for `shape`. A path with a channel is a vector warning icon |
| `clock` | The hub's time of day (`docs/time-of-day.md`), no channel. `style`: `digital`, `analogue` (`digital`); `seconds` (false); `format`: `24h`, `12h` (`24h`, digital); `font`, `size` (56), `align`, `rotate`; analogue: `r` (120), `thickness` hour-hand width (6), `ticks` (true), `tickColor` (`dim`), `secondColor` (`accent`) |
| `image` | `image` (required): the name of an image in the hub's library (1-32 letters, digits, `-` and `_`); `w`, `h` (160 x 160), the box it is drawn in; `fit`: `contain` (whole image, in proportion), `cover` (fills the box in proportion, edges cut off), `stretch` (`contain`); `opacity` (100), `rotate` (0). `channel` is optional: with one, the image shows only while `on` holds (default above 0.5) and can `flash`. See `docs/images.md` |
| `gmeter` | The gauge's own accelerometer as a dot on crosshair rings (`docs/motion.md`), no channel. `r` (180); `range` (1.5; the outer ring in g, 0.5 to 4, rings every half g); `trail` (true; the last two seconds, fading), `peaks` (true; the furthest point each way until Reset peaks), `numbers` (true; lateral and longitudinal g as text); `color` (the numbers), `dotColor` (`accent`), `trackColor` (the rings, `dim`), `peakColor` (`warn`); `font`, `size` (22) |
| `dragtimer` | A drag timer from the vehicle speed (`docs/motion.md`), bound to `vehicle_speed` by the parser. `run`: `0-100`, `strip` (60 ft, 330 ft, 1/8, 1/4 mile with the trap speed), `80-120`, `100-200` (`0-100`); `rollout` (false; standing starts only, the clock starts a foot on); `color`, `doneColor` (the time of a complete run, green), `dimColor` (the run name, state and best, `dim`); `font`, `size` (64) |

`zones` is a list of up to 6 `{ "from": a, "to": b, "color": c }` ranges. On a dial they are
drawn as a coloured band on the rim (a redline). On a ring or bar the indicator takes the
zone's colour while the value is inside it.
