jdennis011/haltech-gauges/hardware/jlcpcb/gauge-adapter-bom.csv

Comment | Designator | Footprint | LCSC Part #
SN65HVD230DR | U1 | SOIC-8 | C12084
PESD2CAN,215 | D2 | SOT-23 | C75176
SS14 | D1 | SMA (DO-214AC) | C2480
CL21B104KBCNNNC | C1 | 0805 | C49678
RC0805FR-0710KL | R1 | 0805 | C17414
43045-0412 | J1, J2 | THT, 4 pins + 2 pegs
61300811121 | P1 | THT
61300211121 | JP1 | THT
Test pad on the spare GPIO | TP1 | bare pad
