jdennis011/haltech-gauges/hardware/jlcpcb/hub-carrier-p4-bom.csv

Comment | Designator | Footprint | LCSC Part #
TJA1051T/3/1J | U2 | SOIC-8 | C38695
SN65HVD230DR | U3 | SOIC-8 | C12084
DS3231SN#T&R | U5 | SOIC-16 wide | C9866
PESD2CAN,215 | D4, D5 | SOT-23 | C75176
SMBJ26CA-E3/52 | D1 | SMB (DO-214AA) | C515606
SS34 | D2 | SMA (DO-214AC) | C8678
SS14 | D3 | SMA (DO-214AC) | C2480
BAT54,215 | D6 | SOT-23 | C8590
2N7002,215 | Q1 | SOT-23 | C8545
1812L200/16DR | F2 | 1812 | C439873
UUD1H101MNL1GS | C1, C3 | 8 x 10 mm | C116241
CL21B105KBFNNNE | C2 | 0805 | C28323
CL21A106KAYNNNE | C4, C5, C16 | 0805 | C15850
CL21B104KBCNNNC | C6, C7, C8, C10, C14, C15 | 0805 | C49678
CL21B472KBANNNC | C9 | 0805 | C1744
RC1206FR-07120RL | R3, R4, R5, R6, R7 | 1206 | C17909
RC0805FR-0710KL | R1, R2, R9, R20 | 0805 | C17414
RC0805FR-07100KL | R8, R24 | 0805 | C149504
RC0805FR-071KL | R21, R22, R23 | 0805 | C17513
43045-0412 | J10, J11 | THT, 4 pins + 2 pegs
PPTC091LFBN-RC | J12 | THT
61300211121 | JP1, JP2 | THT
3034 | BT1 | SMT
D36V28F5 (Pololu item 3782) | U1 | THT module, 1x4 pins
ESP32-P4-WIFI6 (SKU 32020) | U4 | 2 x 20, Raspberry Pi Pico pattern
Test pads: GND, 5 V, 3V3, 12 V sense, RST | TP1-TP5 | bare pads
