jdennis011/haltech-gauges/hardware/jlcpcb/hub-carrier-p4-rev-b-bom.csv

Comment | Designator | Footprint | LCSC Part #
43045-0412 ECU | J10 | MOLEX-43045-0412
SMBJ26CA | D1 | SMB | C515606
SS34 | D2 | SMA | C8678
100u 50V | C1, C3 | CAP-SMD-8X10 | C116241
1u 50V | C2, C17, C18, C21 | 0805 | C28323
D36V28F5 | U1 | POLOLU-D36V28F-PLACEHOLDER
10u 25V | C4, C5, C16, C22 | 0805 | C15850
+5V_RAW | TP6 | TESTPAD
AO3401A | Q7 | SOT23 | C15127
MMBT3906 | Q8 | SOT23
TL431 | U9 | SOT23 | C3113
10k | R40, R43, R45, R1, R2, R9, R20 | 0805 | C17414
2k2 | R41 | 0805 | C17520
15k | R42 | 0805
100n | C19, C20, C23, C6, C7, C8, C10, C14, C15, C24 | 0805 | C49678
SS14 | D3 | SMA | C2480
1812L200/16DR | F2 | 1812 | C439873
43045-0612 CHAIN | J11 | MOLEX-43045-0612
4k7 | R44, R47 | 0805 | C17673
ESP32-P4-WIFI6 | U4 | WAVESHARE-ESP32-P4-WIFI6
TJA1051T/3 | U2, U7 | SOIC8 | C38695
SN65HVD230DR | U3 | SOIC8 | C12084
PESD2CAN | D4, D5, D7 | SOT23 | C75176
120R | R3, R4, R5, R6, R7, R46 | 1206 | C17909
ECU TERM | JP1 | HDR-1X2
4n7 | C9 | 0805 | C1744
VEHICLE TERM | JP3 | HDR-1X2
43045-0612 VEHICLE CAN | J14 | MOLEX-43045-0612
ADAFRUIT 746 SOCKET | J12 | ADAFRUIT-ULTIMATE-GPS
2N7002 | Q1, Q3, Q4, Q5, Q6 | SOT23 | C8545
100k | R24, R48, R50, R51, R52, R53 | 0805 | C149504
1k | R22, R23, R21, R49 | 0805 | C17513
150k | R8 | 0805
DS3231SN# | U5 | SOIC16W | C9866
ML2032 holder | BT1 | CR2032-HOLDER-PLACEHOLDER
XC6206P302MR | U6 | SOT23
BAS70 | D6 | SOT23
ML2032 CHARGE | JP2 | HDR-1X2
RELAY 5V GND IN | J15 | HDR-1X3
AO3400A | Q2 | SOT23 | C20917
BAT54S | D8 | SOT23 | C47546
HORN DIRECT | JP4 | HDR-1X2
REMOTE GND REM SW1-4 | J13 | HDR-1X6
DNP head unit | R30, R31, R32, R33 | AXIAL-10MM
MCP4531T-103E/MS DNP | U8 | MSOP8
GND | TP1 | TESTPAD
+5V | TP2 | TESTPAD
+3V3 | TP3 | TESTPAD
VBAT_SENSE | TP4 | TESTPAD
RST | TP5 | TESTPAD
