jdennis011/haltech-gauges/hardware/gauge-adapter.sch

## EAGLE design hardware/gauge-adapter.sch (2026-10-03)

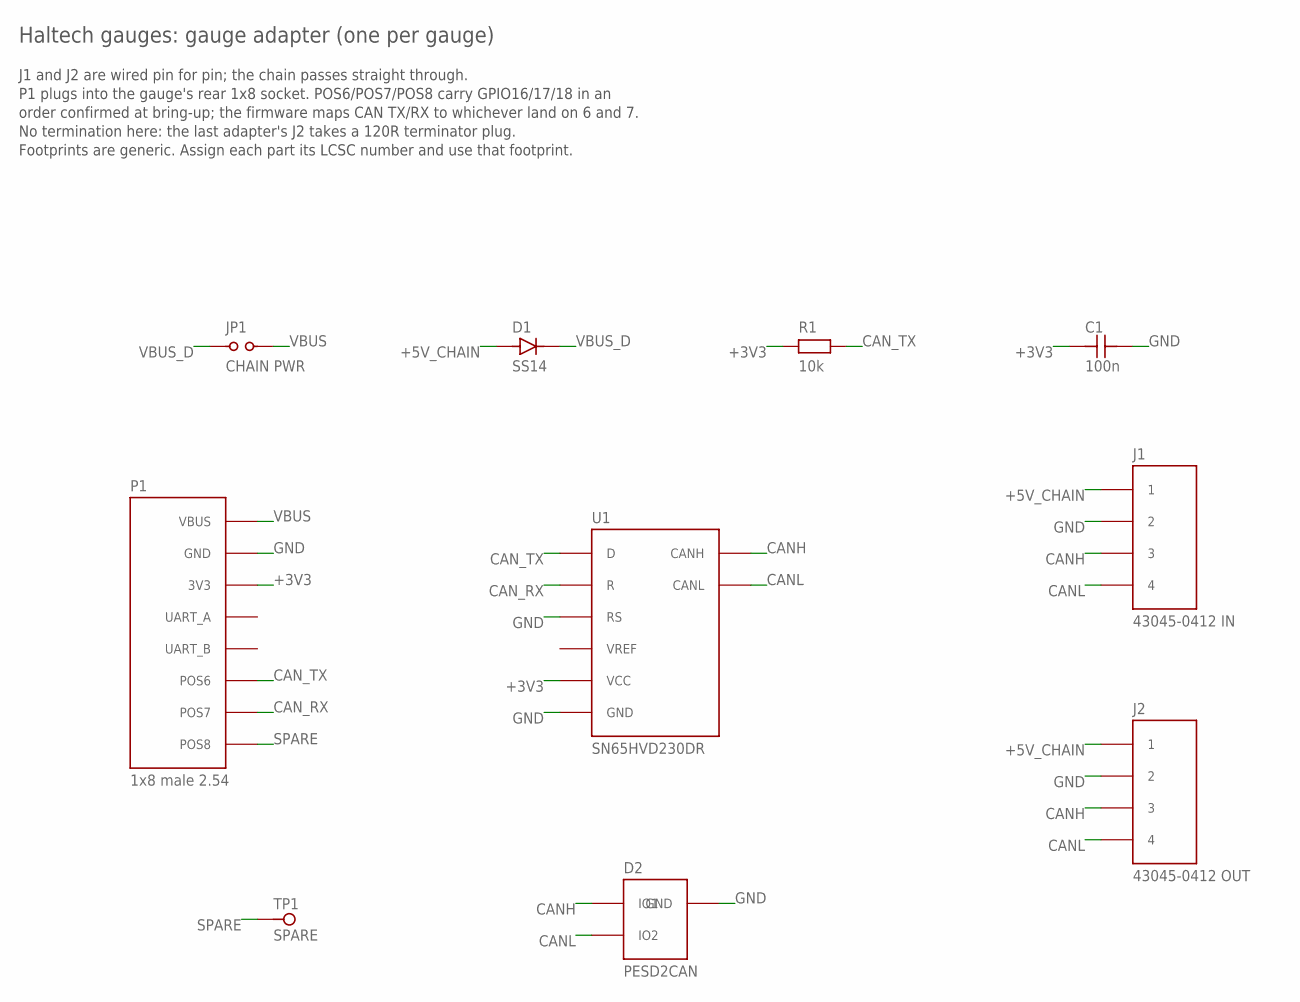
[picture p2: schematic gauge-adapter.sch]

Parts:
C1: 100n; 0805; LCSC C49678
D1: SS14; SMA; LCSC C2480
D2: PESD2CAN; SOT23; LCSC C75176
J1: 43045-0412 IN; MOLEX-43045-0412
J2: 43045-0412 OUT; MOLEX-43045-0412
JP1: CHAIN PWR; HDR-1X2
P1: 1x8 male 2.54; HDR-1X8
R1: 10k; 0805; LCSC C17414
TP1: SPARE; TESTPAD
U1: SN65HVD230DR; SOIC8; LCSC C12084

Connections:
+3V3: C1.1, P1.3 (3V3), R1.1, U1.3 (VCC)
+5V_CHAIN: D1.2 (A), J1.1, J2.1
CANH: D2.1 (IO1), J1.3, J2.3, U1.7 (CANH)
CANL: D2.2 (IO2), J1.4, J2.4, U1.6 (CANL)
CAN_RX: P1.7 (POS7), U1.4 (R)
CAN_TX: P1.6 (POS6), R1.2, U1.1 (D)
GND: C1.2, D2.3 (GND), J1.2, J2.2, P1.2 (GND), U1.2 (GND), U1.8 (RS)
SPARE: P1.8 (POS8), TP1.1
VBUS: JP1.2, P1.1 (VBUS)
VBUS_D: D1.1 (K), JP1.1

Notes on the sheet:
Haltech gauges: gauge adapter (one per gauge)
J1 and J2 are wired pin for pin; the chain passes straight through.
P1 plugs into the gauge's rear 1x8 socket. POS6/POS7/POS8 carry GPIO16/17/18 in an
order confirmed at bring-up; the firmware maps CAN TX/RX to whichever land on 6 and 7.
No termination here: the last adapter's J2 takes a 120R terminator plug.
Footprints are generic. Assign each part its LCSC number and use that footprint.
