jdennis011/haltech-gauges/hardware/hub-carrier-p4-rev-b.sch

## EAGLE design hardware/hub-carrier-p4-rev-b.sch (2026-10-28)

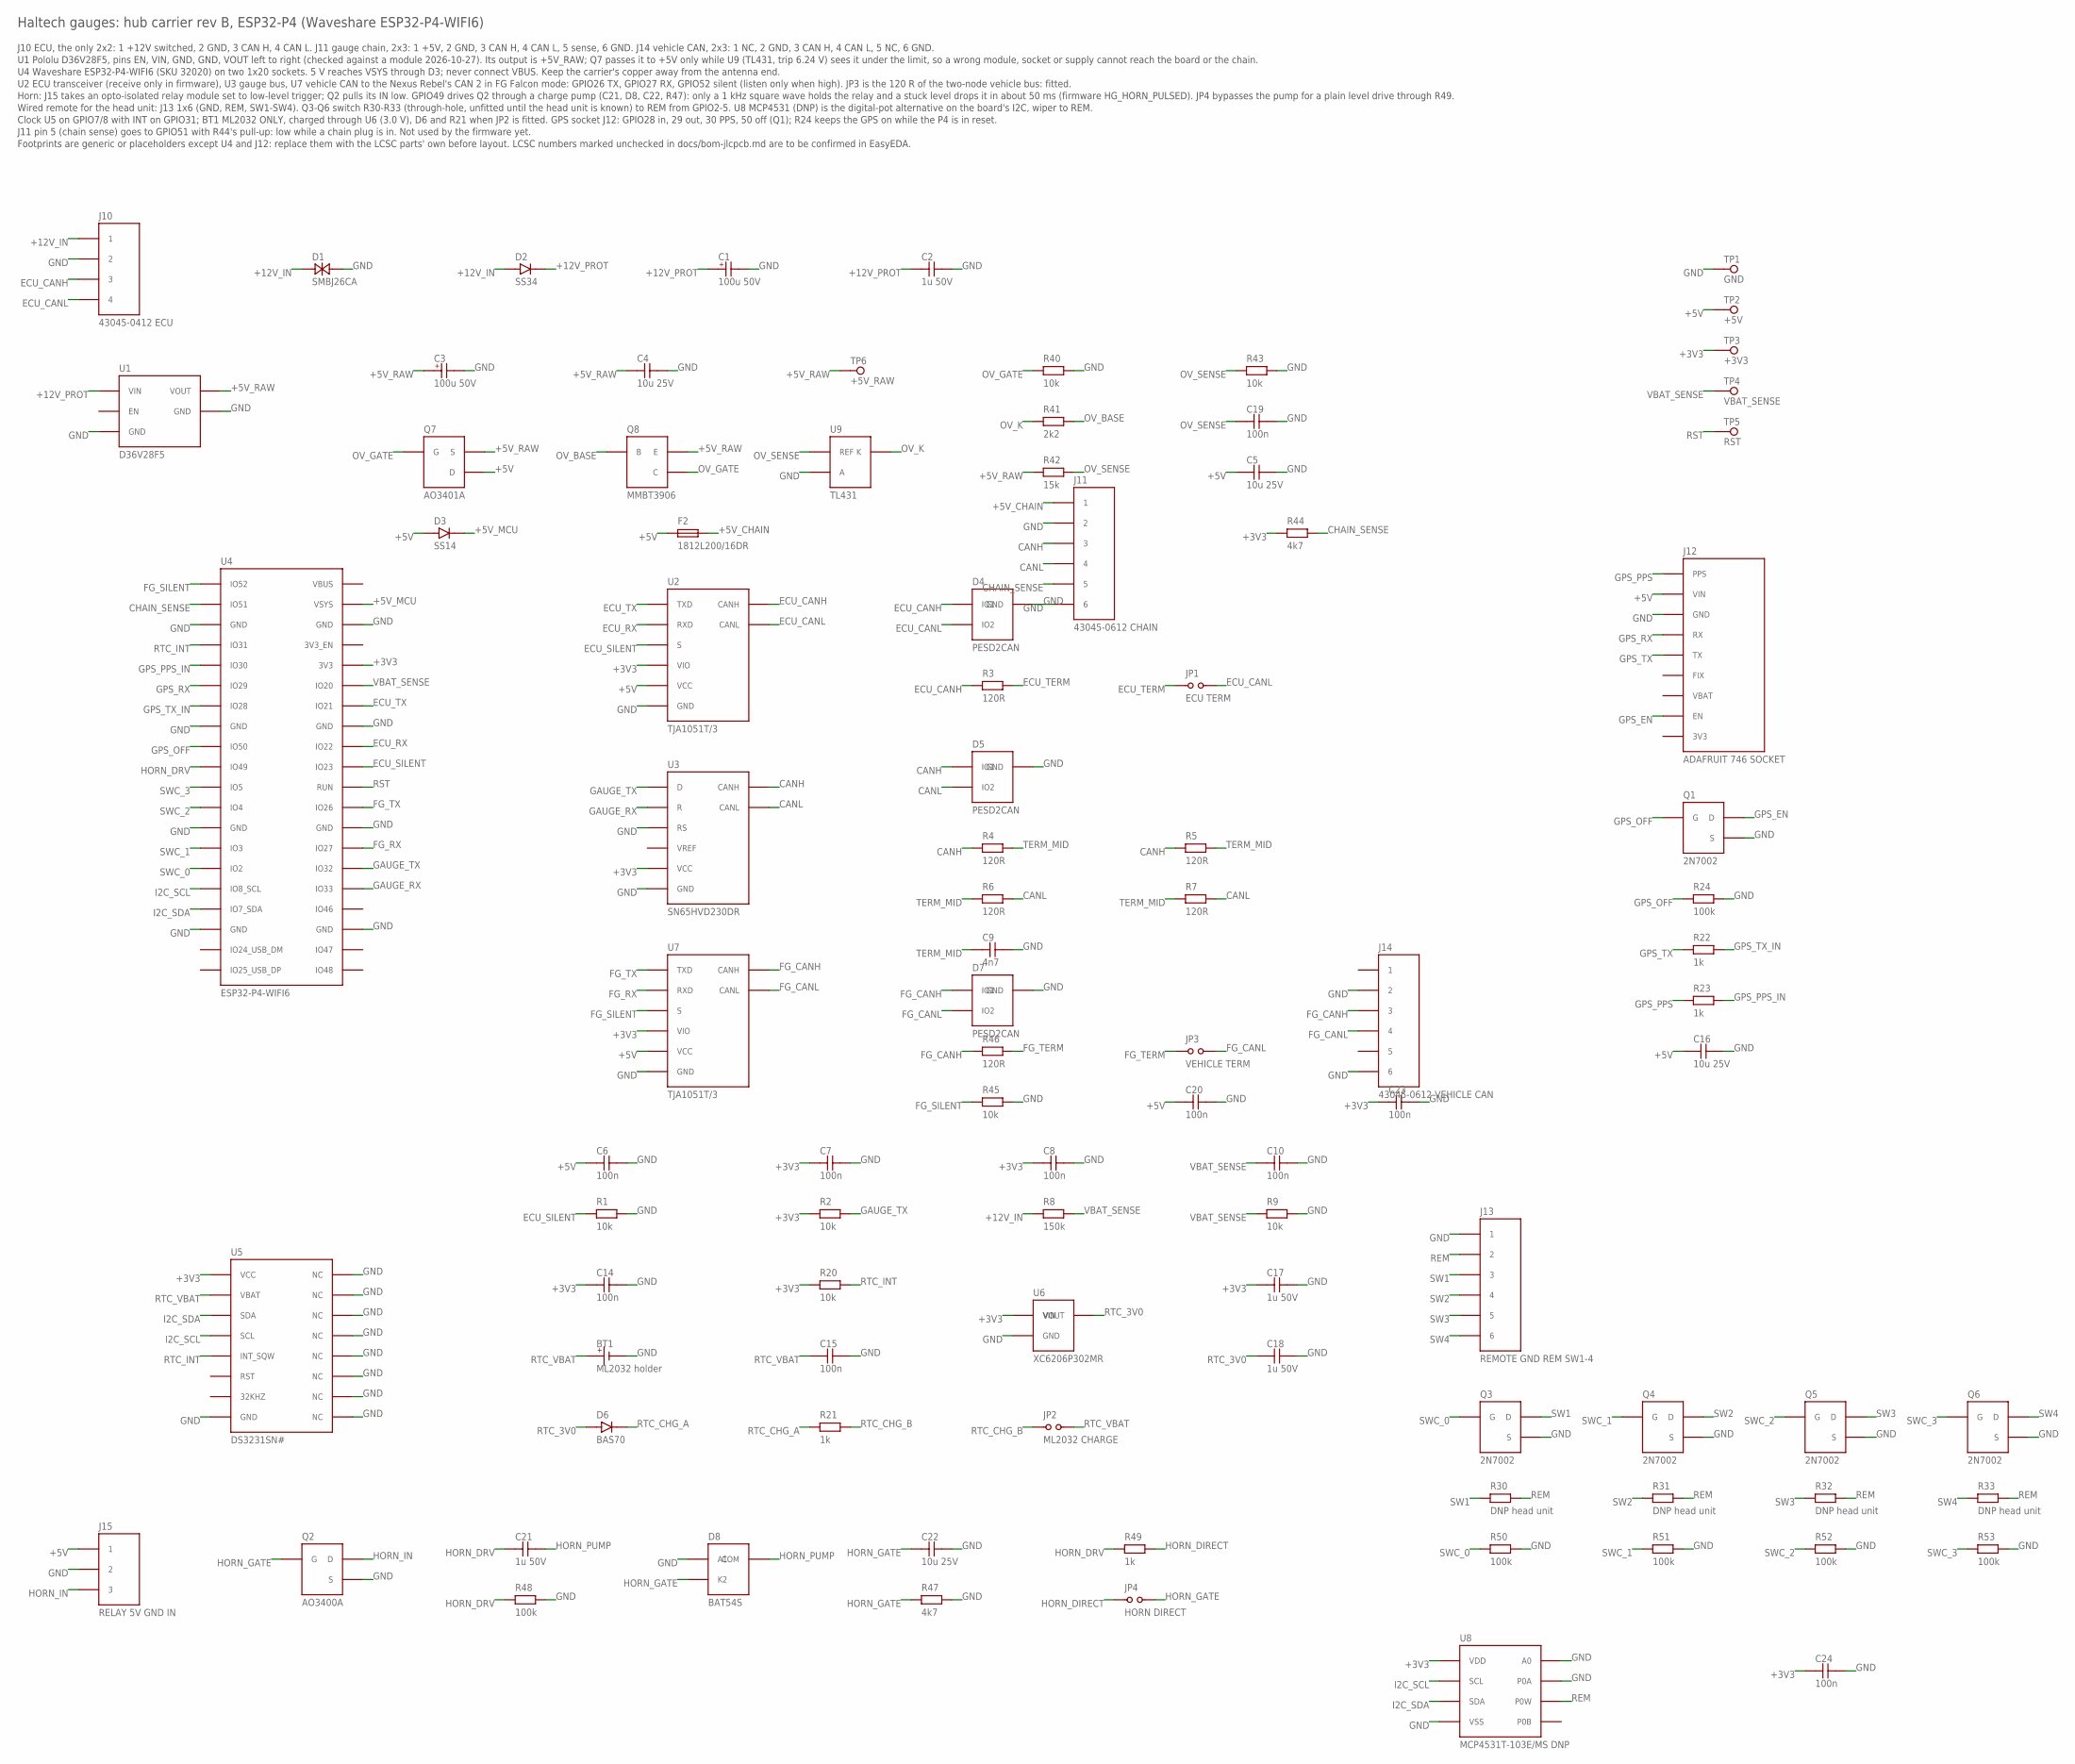
[picture p3: schematic hub-carrier-p4-rev-b.sch]

Parts:
BT1: ML2032 holder; CR2032-HOLDER-PLACEHOLDER
C1, C3: 100u 50V; CAP-SMD-8X10; LCSC C116241
C2, C17, C18, C21: 1u 50V; 0805; LCSC C28323
C4, C5, C16, C22: 10u 25V; 0805; LCSC C15850
C6, C7, C8, C10, C14, C15, C19, C20, C23, C24: 100n; 0805; LCSC C49678
C9: 4n7; 0805; LCSC C1744
D1: SMBJ26CA; SMB; LCSC C515606
D2: SS34; SMA; LCSC C8678
D3: SS14; SMA; LCSC C2480
D4, D5, D7: PESD2CAN; SOT23; LCSC C75176
D6: BAS70; SOT23
D8: BAT54S; SOT23; LCSC C47546
F2: 1812L200/16DR; 1812; LCSC C439873
J10: 43045-0412 ECU; MOLEX-43045-0412
J11: 43045-0612 CHAIN; MOLEX-43045-0612
J12: ADAFRUIT 746 SOCKET; ADAFRUIT-ULTIMATE-GPS
J13: REMOTE GND REM SW1-4; HDR-1X6
J14: 43045-0612 VEHICLE CAN; MOLEX-43045-0612
J15: RELAY 5V GND IN; HDR-1X3
JP1: ECU TERM; HDR-1X2
JP2: ML2032 CHARGE; HDR-1X2
JP3: VEHICLE TERM; HDR-1X2
JP4: HORN DIRECT; HDR-1X2
Q1, Q3, Q4, Q5, Q6: 2N7002; SOT23; LCSC C8545
Q2: AO3400A; SOT23; LCSC C20917
Q7: AO3401A; SOT23; LCSC C15127
Q8: MMBT3906; SOT23
R1, R2, R9, R20, R40, R43, R45: 10k; 0805; LCSC C17414
R3, R4, R5, R6, R7, R46: 120R; 1206; LCSC C17909
R8: 150k; 0805
R21, R22, R23, R49: 1k; 0805; LCSC C17513
R24, R48, R50, R51, R52, R53: 100k; 0805; LCSC C149504
R30, R31, R32, R33: DNP head unit; AXIAL-10MM
R41: 2k2; 0805; LCSC C17520
R42: 15k; 0805
R44, R47: 4k7; 0805; LCSC C17673
TP1: GND; TESTPAD
TP2: +5V; TESTPAD
TP3: +3V3; TESTPAD
TP4: VBAT_SENSE; TESTPAD
TP5: RST; TESTPAD
TP6: +5V_RAW; TESTPAD
U1: D36V28F5; POLOLU-D36V28F-PLACEHOLDER
U2, U7: TJA1051T/3; SOIC8; LCSC C38695
U3: SN65HVD230DR; SOIC8; LCSC C12084
U4: ESP32-P4-WIFI6; WAVESHARE-ESP32-P4-WIFI6
U5: DS3231SN#; SOIC16W; LCSC C9866
U6: XC6206P302MR; SOT23
U8: MCP4531T-103E/MS DNP; MSOP8
U9: TL431; SOT23; LCSC C3113

Connections:
+3V3: C7.1, C8.1, C14.1, C17.1, C23.1, C24.1, R2.1, R20.1, R44.1, TP3.1, U2.5 (VIO), U3.3 (VCC), U4.36 (3V3), U5.2 (VCC), U6.3 (VIN), U7.5 (VIO), U8.1 (VDD)
+5V: C5.1, C6.1, C16.1, C20.1, D3.2 (A), F2.1, J12.2 (VIN), J15.1, Q7.3 (D), TP2.1, U2.3 (VCC), U7.3 (VCC)
+5V_CHAIN: F2.2, J11.1
+5V_MCU: D3.1 (K), U4.39 (VSYS)
+5V_RAW: C3.1 (+), C4.1, Q7.2 (S), Q8.2 (E), R42.1, TP6.1, U1.VOUT
+12V_IN: D1.1, D2.2 (A), J10.1, R8.1
+12V_PROT: C1.1 (+), C2.1, D2.1 (K), U1.VIN
CANH: D5.1 (IO1), J11.3, R4.1, R5.1, U3.7 (CANH)
CANL: D5.2 (IO2), J11.4, R6.2, R7.2, U3.6 (CANL)
CHAIN_SENSE: J11.5, R44.2, U4.2 (IO51)
ECU_CANH: D4.1 (IO1), J10.3, R3.1, U2.7 (CANH)
ECU_CANL: D4.2 (IO2), J10.4, JP1.2, U2.6 (CANL)
ECU_RX: U2.4 (RXD), U4.32 (IO22)
ECU_SILENT: R1.1, U2.8 (S), U4.31 (IO23)
ECU_TERM: JP1.1, R3.2
ECU_TX: U2.1 (TXD), U4.34 (IO21)
FG_CANH: D7.1 (IO1), J14.3, R46.1, U7.7 (CANH)
FG_CANL: D7.2 (IO2), J14.4, JP3.2, U7.6 (CANL)
FG_RX: U4.27 (IO27), U7.4 (RXD)
FG_SILENT: R45.1, U4.1 (IO52), U7.8 (S)
FG_TERM: JP3.1, R46.2
FG_TX: U4.29 (IO26), U7.1 (TXD)
GAUGE_RX: U3.4 (R), U4.25 (IO33)
GAUGE_TX: R2.2, U3.1 (D), U4.26 (IO32)
GND: BT1.NEG (-), C1.2 (-), C2.2, C3.2 (-), C4.2, C5.2, C6.2, C7.2, C8.2, C9.2, C10.2, C14.2, C15.2, C16.2, C17.2, C18.2, C19.2, C20.2, C22.2, C23.2, C24.2, D1.2, D4.3 (GND), D5.3 (GND), D7.3 (GND), D8.1 (A1), J10.2, J11.2, J11.6, J12.3 (GND), J13.1, J14.2, J14.6, J15.2, Q1.2 (S), Q2.2 (S), Q3.2 (S), Q4.2 (S), Q5.2 (S), Q6.2 (S), R1.2, R9.2, R24.2, R40.2, R43.2, R45.2, R47.2, R48.2, R50.2, R51.2, R52.2, R53.2, TP1.1, U1.GND1 (GND), U1.GND2 (GND), U2.2 (GND), U3.2 (GND), U3.8 (RS), U4.3 (GND), U4.8 (GND), U4.13 (GND), U4.18 (GND), U4.23 (GND), U4.28 (GND), U4.33 (GND), U4.38 (GND), U5.5 (NC), U5.6 (NC), U5.7 (NC), U5.8 (NC), U5.9 (NC), U5.10 (NC), U5.11 (NC), U5.12 (NC), U5.13 (GND), U6.1 (GND), U7.2 (GND), U8.4 (VSS), U8.7 (P0A), U8.8 (A0), U9.2 (A)
GPS_EN: J12.8 (EN), Q1.3 (D)
GPS_OFF: Q1.1 (G), R24.1, U4.9 (IO50)
GPS_PPS: J12.1 (PPS), R23.1
GPS_PPS_IN: R23.2, U4.5 (IO30)
GPS_RX: J12.4 (RX), U4.6 (IO29)
GPS_TX: J12.5 (TX), R22.1
GPS_TX_IN: R22.2, U4.7 (IO28)
HORN_DIRECT: JP4.1, R49.2
HORN_DRV: C21.1, R48.1, R49.1, U4.10 (IO49)
HORN_GATE: C22.1, D8.2 (K2), JP4.2, Q2.1 (G), R47.1
HORN_IN: J15.3, Q2.3 (D)
HORN_PUMP: C21.2, D8.3 (COM)
I2C_SCL: U4.16 (IO8_SCL), U5.16 (SCL), U8.2 (SCL)
I2C_SDA: U4.17 (IO7_SDA), U5.15 (SDA), U8.3 (SDA)
OV_BASE: Q8.1 (B), R41.2
OV_GATE: Q7.1 (G), Q8.3 (C), R40.1
OV_K: R41.1, U9.3 (K)
OV_SENSE: C19.1, R42.2, R43.1, U9.1 (REF)
REM: J13.2, R30.2, R31.2, R32.2, R33.2, U8.6 (P0W)
RST: TP5.1, U4.30 (RUN)
RTC_3V0: C18.1, D6.1 (A), U6.2 (VOUT)
RTC_CHG_A: D6.3 (K), R21.1
RTC_CHG_B: JP2.1, R21.2
RTC_INT: R20.2, U4.4 (IO31), U5.3 (INT_SQW)
RTC_VBAT: BT1.POS (+), C15.1, JP2.2, U5.14 (VBAT)
SW1: J13.3, Q3.3 (D), R30.1
SW2: J13.4, Q4.3 (D), R31.1
SW3: J13.5, Q5.3 (D), R32.1
SW4: J13.6, Q6.3 (D), R33.1
SWC_0: Q3.1 (G), R50.1, U4.15 (IO2)
SWC_1: Q4.1 (G), R51.1, U4.14 (IO3)
SWC_2: Q5.1 (G), R52.1, U4.12 (IO4)
SWC_3: Q6.1 (G), R53.1, U4.11 (IO5)
TERM_MID: C9.1, R4.2, R5.2, R6.1, R7.1
VBAT_SENSE: C10.1, R8.2, R9.1, TP4.1, U4.35 (IO20)

Notes on the sheet:
Haltech gauges: hub carrier rev B, ESP32-P4 (Waveshare ESP32-P4-WIFI6)
J10 ECU, the only 2x2: 1 +12V switched, 2 GND, 3 CAN H, 4 CAN L. J11 gauge chain, 2x3: 1 +5V, 2 GND, 3 CAN H, 4 CAN L, 5 sense, 6 GND. J14 vehicle CAN, 2x3: 1 NC, 2 GND, 3 CAN H, 4 CAN L, 5 NC, 6 GND.
U1 Pololu D36V28F5, pins EN, VIN, GND, GND, VOUT left to right (checked against a module 2026-10-27). Its output is +5V_RAW; Q7 passes it to +5V only while U9 (TL431, trip 6.24 V) sees it under the limit, so a wrong module, socket or supply cannot reach the board or the chain.
U4 Waveshare ESP32-P4-WIFI6 (SKU 32020) on two 1x20 sockets. 5 V reaches VSYS through D3; never connect VBUS. Keep the carrier's copper away from the antenna end.
U2 ECU transceiver (receive only in firmware), U3 gauge bus, U7 vehicle CAN to the Nexus Rebel's CAN 2 in FG Falcon mode: GPIO26 TX, GPIO27 RX, GPIO52 silent (listen only when high). JP3 is the 120 R of the two-node vehicle bus: fitted.
Horn: J15 takes an opto-isolated relay module set to low-level trigger; Q2 pulls its IN low. GPIO49 drives Q2 through a charge pump (C21, D8, C22, R47): only a 1 kHz square wave holds the relay and a stuck level drops it in about 50 ms (firmware HG_HORN_PULSED). JP4 bypasses the pump for a plain le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
Wired remote for the head unit: J13 1x6 (GND, REM, SW1-SW4). Q3-Q6 switch R30-R33 (through-hole, unfitted until the head unit is known) to REM from GPIO2-5. U8 MCP4531 (DNP) is the digital-pot alternative on the board's I2C, wiper to REM.
Clock U5 on GPIO7/8 with INT on GPIO31; BT1 ML2032 ONLY, charged through U6 (3.0 V), D6 and R21 when JP2 is fitted. GPS socket J12: GPIO28 in, 29 out, 30 PPS, 50 off (Q1); R24 keeps the GPS on while the P4 is in reset.
J11 pin 5 (chain sense) goes to GPIO51 with R44's pull-up: low while a chain plug is in. Not used by the firmware yet.
Footprints are generic or placeholders except U4 and J12: replace them with the LCSC parts' own before layout. LCSC numbers marked unchecked in docs/bom-jlcpcb.md are to be confirmed in EasyEDA.
