jdennis011/haltech-gauges/src/gauge/main.cpp

#include <Arduino.h>
#include <esp_system.h>

#include "audio.h"
#include "board.h"
#include "can_task.h"
#include "display.h"
#include "face_ui.h"
#include "imu.h"
#include "serial_console.h"
#include "splash.h"
#include "touch.h"

// LVGL's software renderer and the TTF rasteriser need more than the default
// 8 KB, and ThorVG (the path widgets and the boot splash) keeps a 16 KB cell
// buffer on the stack of the task that draws (tvgSwRle.cpp, rleRender). With a
// 16 KB stack that buffer landed below the stack, past the canary, and smashed
// the heap: the idle task then died in the task watchdog's list. 48 KB.
SET_LOOP_TASK_STACK_SIZE(48 * 1024);

// A build installed over Wi-Fi is confirmed by face_store::markHealthy() after
// ten seconds of running, not by the core at start, so a bad one is rolled back.
extern "C" bool verifyRollbackLater() { return true; }

void setup() {
    Serial.setRxBufferSize(8192);  // a config pasted into the console arrives faster than the loop runs
    Serial.begin(115200);
    Serial.setTxTimeoutMs(0);  // never block on USB CDC when no host is attached

    board::begin();
    Serial.printf("Gauge firmware on %s, %d px, reset reason %d\n", board::name(), display::kSize, int(esp_reset_reason()));

    if (!display::begin()) Serial.println("Display start failed");
    if (!touch::begin()) Serial.println("Touch start failed");
    audio::begin();
    imu::begin();
    splash::begin();  // the panel shows oaGauge while the rest starts

    can_task::begin();
    face_ui::begin();
    serial_console::begin();
}

void loop() {
    board::update();
    face_ui::update();
    display::loop();
    serial_console::poll();
    audio::poll();

    static uint32_t lastPowerMs = 0;
    if (millis() - lastPowerMs >= 1000) {
        lastPowerMs = millis();
        can_task::setVbusMillivolts(board::vbusMillivolts());
    }

    if (can_task::rebootRequested()) {
        delay(200);  // let the acknowledgement go out first
        ESP.restart();
    }

    delay(1);
}
