jdennis011/haltech-gauges/src/gauge/can_task.cpp

#include "can_task.h"

#include <Arduino.h>
#include <ESP32-TWAI-CAN.hpp>
#include <Preferences.h>
#include <esp_heap_caps.h>
#include <esp_mac.h>

#include <atomic>

#include "audio.h"
#include "board_pins.h"
#include "face_model.h"
#include "face_store.h"
#include "ip_link.h"
#include "wifi_fetch.h"
#include "gauge_node.h"
#include "image_store.h"
#include "version.h"

using namespace hg;

namespace can_task {

namespace {

ChannelStore store;
proto::GaugeNode node;

std::atomic<uint32_t> frames{0};
std::atomic<uint32_t> lastWireLiveMs{0};  // the last Haltech frame off the wire
std::atomic<uint32_t> lastIpLiveMs{0};    // and off the IP link
std::atomic<bool> hub{false};
std::atomic<uint32_t> currentNode{0};
std::atomic<uint16_t> vbus{0};
std::atomic<uint32_t> identifyUntil{0};
std::atomic<int> brightnessRequest{-1};
std::atomic<int> faceRequest{-1};
std::atomic<int> displayRequest{-1};
std::atomic<bool> holdReset{false};
std::atomic<bool> reboot{false};
std::atomic<bool> demoMode{true};

// The key-on intro the hub asked for, for the UI loop.
portMUX_TYPE introMux = portMUX_INITIALIZER_UNLOCKED;
proto::Intro introNow;
std::atomic<bool> introPending{false};

// Requests for all gauges from the pull-down menu, sent from this task.
portMUX_TYPE requestMux = portMUX_INITIALIZER_UNLOCKED;
proto::Request requestRing[4];
uint8_t requestHead = 0;
uint8_t requestTail = 0;

// The frames the faces use, for the hub (proto::Needs).
portMUX_TYPE runMux = portMUX_INITIALIZER_UNLOCKED;
proto::RunResult runRing[8];
uint8_t runHead = 0, runTail = 0;
portMUX_TYPE needsMux = portMUX_INITIALIZER_UNLOCKED;
uint64_t needsParts[proto::kNeedsParts] = {};
bool needsKnown = false;
std::atomic<bool> needsDirty{false};

// Images fetched over Wi-Fi, to be reported to the hub from this task.
portMUX_TYPE reportMux = portMUX_INITIALIZER_UNLOCKED;
uint32_t reportRing[16];
uint8_t reportHead = 0;
uint8_t reportTail = 0;

// Written by the CAN task, read by the UI loop.
portMUX_TYPE alertMux = portMUX_INITIALIZER_UNLOCKED;
proto::Alert alertNow;
uint32_t themeNow[proto::kThemeColourCount];
const char* kThemeKey = "tcolours";

const char* kPrefsNamespace = "gauge";
const char* kNodeKey = "node";

bool canSend(const hg::CanFrame& frame, void*) {
    ::CanFrame out = {};
    out.identifier = frame.id;
    out.extd = frame.extended;
    out.data_length_code = frame.len;
    memcpy(out.data, frame.data, frame.len);
    bool sent = ESP32Can.writeFrame(out, 0);
    // A hub reached over Wi-Fi gets it too (docs/ip-link.md).
    if (ip_link::connected() && ip_link::send(frame)) sent = true;
    return sent;
}

void onIntro(const proto::Intro& intro, void*) {
    portENTER_CRITICAL(&introMux);
    introNow = intro;
    portEXIT_CRITICAL(&introMux);
    introPending = true;
}

bool onCommand(proto::Cmd cmd, uint8_t arg, void*) {
    switch (cmd) {
        case proto::Cmd::Identify: {
            uint32_t until = millis() + uint32_t(arg) * 1000;
            if (until == 0) until = 1;  // 0 means "not requested"
            identifyUntil = until;
            audio::chime();
            return true;
        }
        case proto::Cmd::SetBrightness:
            brightnessRequest = arg;
            return true;
        case proto::Cmd::Reboot:
            reboot = true;
            return true;
        case proto::Cmd::SetFace:
            if (arg >= face_store::faceCount()) return false;
            faceRequest = arg;
            return true;
        case proto::Cmd::SetDisplay:
            displayRequest = arg ? 1 : 0;
            return true;
        case proto::Cmd::EndTry:
            face_store::endTry();
            return true;
        case proto::Cmd::PlaySound:
            audio::play(arg);
            return true;
        case proto::Cmd::SetVolume:
            audio::setVolume(arg > 100 ? 100 : arg);
            return true;
        case proto::Cmd::ResetHold:
            holdReset = true;
            return true;
        case proto::Cmd::SendConfig: {
            size_t size = 0;
            const uint8_t* data = face_store::storedBytes(size);
            return data && node.upload(data, uint32_t(size), millis());
        }
        default:
            return false;
    }
}

void onAlert(const proto::Alert& alert, void*) {
    portENTER_CRITICAL(&alertMux);
    alertNow = alert;
    portEXIT_CRITICAL(&alertMux);
    if (alert.show) {
        Serial.printf("Alert: %s\n", alert.text);
    } else {
        Serial.println("Alert cleared");
    }
}

void onThemeColours(const uint32_t colours[proto::kThemeColourCount], void*) {
    portENTER_CRITICAL(&alertMux);
    memcpy(themeNow, colours, sizeof(themeNow));
    portEXIT_CRITICAL(&alertMux);
    Preferences prefs;
    prefs.begin(kPrefsNamespace, false);
    prefs.putBytes(kThemeKey, colours, sizeof(themeNow));
    prefs.end();
    Serial.println("Theme colours updated by the hub");
}

void onStatus(proto::Status& status, void*) {
    status.configCrc = face_store::storedCrc();
    status.activeFace = face_store::activeFace();
    status.faceCount = uint8_t(face_store::faceCount());
    status.vbusMillivolts = vbus;
    status.flags = (face_store::trying() ? proto::kStatusFlagTrying : 0) | (demoMode ? proto::kStatusFlagDemo : 0) |
                   (wifi_fetch::busy() ? proto::kStatusFlagWifi : 0) |
                   uint8_t(proto::statusVolumeField(audio::present(), audio::volume()) << proto::kStatusVolumeShift);
}

// Images are taken in to PSRAM and handed to the image store, which writes
// them to flash in the background; configs go to the face store, which parses
// them here and hands them to the UI task.
uint8_t* rxBuffer = nullptr;

void freeRxBuffer() {
    free(rxBuffer);
    rxBuffer = nullptr;
}

proto::XferStatus onTransferAccept(proto::XferKind kind, uint32_t size, uint8_t** buffer, void*) {
    if (kind != proto::XferKind::Image) return face_store::accept(kind, size, buffer);
    if (size > image_store::maxImageBytes() || !image_store::roomFor(size)) return proto::XferStatus::TooBig;
    freeRxBuffer();
    const size_t bytes = size ? size : 1;
    rxBuffer = static_cast<uint8_t*>(heap_caps_malloc(bytes, MALLOC_CAP_SPIRAM | MALLOC_CAP_8BIT));
    if (!rxBuffer) rxBuffer = static_cast<uint8_t*>(malloc(bytes));  // a board without PSRAM
    if (!rxBuffer) return proto::XferStatus::Busy;
    *buffer = rxBuffer;
    return proto::XferStatus::Ok;
}

bool onTransferComplete(proto::XferKind kind, const uint8_t* data, uint32_t size, void*) {
    if (kind == proto::XferKind::WifiJoin) {
        const bool ok = wifi_fetch::start(data, size);
        face_store::dropped();  // the buffer was the face store's
        return ok;
    }
    if (kind != proto::XferKind::Image) return face_store::complete(kind, data, size);
    if (!rxBuffer) return false;
    uint8_t* owned = rxBuffer;
    rxBuffer = nullptr;
    return image_store::submit(owned, size);  // the store owns the buffer now
}

void onTransferDropped(void*) {
    freeRxBuffer();
    face_store::dropped();
}

bool onHasImage(uint32_t crc, void*) { return image_store::has(crc); }

uint32_t loadNode(const uint8_t mac[6]) {
    Preferences prefs;
    prefs.begin(kPrefsNamespace, true);
    const uint32_t saved = prefs.getUInt(kNodeKey, proto::kBroadcastNode);
    prefs.end();
    return saved == proto::kBroadcastNode ? proto::GaugeNode::nodeFromMac(mac) : saved;
}

void saveNode(uint32_t id) {
    Preferences prefs;
    prefs.begin(kPrefsNamespace, false);
    prefs.putUInt(kNodeKey, id);
    prefs.end();
}

void serviceBus() {
    const uint32_t state = ESP32Can.canState();
    if (state == TWAI_STATE_BUS_OFF) {
        ESP32Can.recover();
    } else if (state == TWAI_STATE_STOPPED) {
        ESP32Can.restart();
    }
}

void task(void*) {
    ::CanFrame rx;
    uint32_t lastServiceMs = 0;
    uint32_t lastNeedsMs = 0;
    bool hubWas = false;
    for (;;) {
        bool got = ESP32Can.readFrame(rx, 5);
        while (got) {
            hg::CanFrame f;
            f.id = rx.identifier;
            f.extended = rx.extd;
            f.len = rx.data_length_code > 8 ? 8 : rx.data_length_code;
            memcpy(f.data, rx.data, f.len);
            frames++;

            const uint32_t now = millis();
            if (f.extended) {
                node.onFrame(f, now);
            } else {
                store.onFrame(f, now);
                lastWireLiveMs = now;
            }
            got = ESP32Can.readFrame(rx, 0);
        }

        const uint32_t now = millis();
        // Frames from a hub reached over Wi-Fi take the same path as the bus's.
        ip_link::service(now);
        hg::CanFrame linked;
        while (ip_link::read(linked)) {
            frames++;
            if (linked.extended) {
                node.onFrame(linked, now);
            } else {
                store.onFrame(linked, now);
                lastIpLiveMs = now;
            }
        }
        node.poll(now);
        hub = node.hubPresent();

        // What the faces need from the bus: on a change, when the hub appears,
        // and every few seconds in case a frame was lost (docs/frame-filter.md).
        const bool hubNow = node.hubPresent();
        if (hubNow && (needsDirty || !hubWas || uint32_t(now - lastNeedsMs) >= 3000)) {
            uint64_t parts[proto::kNeedsParts];
            portENTER_CRITICAL(&needsMux);
            const bool known = needsKnown;
            memcpy(parts, needsParts, sizeof(parts));
            portEXIT_CRITICAL(&needsMux);
            if (known) {
                bool ok = true;
                for (size_t p = 0; p < proto::kNeedsParts; p++) ok = node.sendNeeds(uint8_t(p), frameTableTag(), parts[p]) && ok;
                if (ok) {
                    needsDirty = false;
                    lastNeedsMs = now;
                }
            }
        }
        hubWas = hubNow;

        // The menu's "all gauges" requests.
        for (;;) {
            proto::Request rq;
            bool any = false;
            portENTER_CRITICAL(&requestMux);
            if (requestHead != requestTail) {
                rq = requestRing[requestTail];
                any = true;
            }
            portEXIT_CRITICAL(&requestMux);
            if (!any || !node.request(rq.cmd, rq.arg, true)) break;
            portENTER_CRITICAL(&requestMux);
            requestTail = uint8_t((requestTail + 1) % 4);
            portEXIT_CRITICAL(&requestMux);
        }

        // Finished drag timer runs, a split per frame.
        for (;;) {
            proto::RunResult rr;
            bool any = false;
            portENTER_CRITICAL(&runMux);
            if (runHead != runTail) {
                rr = runRing[runTail];
                any = true;
            }
            portEXIT_CRITICAL(&runMux);
            if (!any) break;
            if (!hubNow) {
                portENTER_CRITICAL(&runMux);
                runTail = runHead;  // no hub: nothing to tell
                portEXIT_CRITICAL(&runMux);
                break;
            }
            if (!node.sendRunResult(rr)) break;
            portENTER_CRITICAL(&runMux);
            runTail = uint8_t((runTail + 1) % 8);
            portEXIT_CRITICAL(&runMux);
        }

        // Images that arrived over Wi-Fi: the hub hears of each at once.
        for (;;) {
            uint32_t crc = 0;
            bool any = false;
            portENTER_CRITICAL(&reportMux);
            if (reportHead != reportTail) {
                crc = reportRing[reportTail];
                any = true;
            }
            portEXIT_CRITICAL(&reportMux);
            if (!any || !node.reportAsset(crc, true)) break;  // no hub or no room: again next time
            portENTER_CRITICAL(&reportMux);
            reportTail = uint8_t((reportTail + 1) % 16);
            portEXIT_CRITICAL(&reportMux);
        }

        if (node.idConflict()) {
            // Another gauge has the same id: take a random one and keep it.
            uint32_t id = esp_random() & 0xFFFFFF;
            if (id == proto::kBroadcastNode) id = 0xFFFFFE;
            saveNode(id);
            node.setNode(id);
            currentNode = id;
        }

        if (now - lastServiceMs >= 500) {
            lastServiceMs = now;
            serviceBus();
        }
    }
}

}  // namespace

void begin() {
    ESP32Can.setPins(PIN_CAN_TX, PIN_CAN_RX);
    ESP32Can.setRxQueueSize(128);
    ESP32Can.setTxQueueSize(16);
    if (!ESP32Can.begin(TWAI_SPEED_1000KBPS)) Serial.println("CAN start failed");

    if (!image_store::begin()) Serial.println("Image storage failed to mount");
    face_store::begin();
    wifi_fetch::begin();
    ip_link::begin();

    uint8_t mac[6];
    esp_read_mac(mac, ESP_MAC_WIFI_STA);
    const uint32_t id = loadNode(mac);
    currentNode = id;

    proto::Info info;
    info.fwMajor = FW_VERSION_MAJOR;
    info.fwMinor = FW_VERSION_MINOR;
    info.fwPatch = FW_VERSION_PATCH;
#if HG_BOARD_M5DIAL
    info.hwRevision = proto::kBoardM5Dial;
#else
    info.hwRevision = proto::kBoardWaveshare175;
#endif

    proto::GaugeNode::Handler handler = {};
    handler.command = onCommand;
    handler.status = onStatus;
    handler.alert = onAlert;
    handler.themeColours = onThemeColours;
    handler.transfer = {onTransferAccept, onTransferComplete, onTransferDropped, nullptr};
    handler.hasImage = onHasImage;
    handler.intro = onIntro;
    node.init({canSend, nullptr}, mac, id, info, cfg::kSchemaVersion, handler);
    {
        // The last theme colours the hub sent, or the defaults.
        const cfg::ThemeColours defaults;
        memcpy(themeNow, defaults.value, sizeof(themeNow));
        Preferences prefs;
        prefs.begin(kPrefsNamespace, true);
        if (prefs.getBytesLength(kThemeKey) == sizeof(themeNow)) prefs.getBytes(kThemeKey, themeNow, sizeof(themeNow));
        prefs.end();
        node.setThemeColours(themeNow);
    }

    xTaskCreatePinnedToCore(task, "can", 6144, nullptr, 18, nullptr, 0);
}

ChannelStore& channels() { return store; }
uint32_t framesReceived() { return frames; }

BusCounters busCounters() {
    BusCounters c{};
    c.frames = frames;
    c.state = ESP32Can.canState();
    c.tec = ESP32Can.txErrorCounter();
    c.rec = ESP32Can.rxErrorCounter();
    c.busErrors = ESP32Can.busErrCounter();
    c.rxMissed = ESP32Can.rxMissedCounter();
    c.txFailed = ESP32Can.txFailedCounter();
    return c;
}
bool hubPresent() { return hub; }

LiveLink liveLink(uint32_t nowMs) {
    const uint32_t wire = lastWireLiveMs, ip = lastIpLiveMs;
    if (wire && uint32_t(nowMs - wire) < 1000) return LiveLink::Can;
    if (ip && uint32_t(nowMs - ip) < 1000) return LiveLink::Wifi;
    return LiveLink::None;
}

void setNeeds(const uint64_t parts[proto::kNeedsParts]) {
    portENTER_CRITICAL(&needsMux);
    const bool same = needsKnown && memcmp(parts, needsParts, sizeof(needsParts)) == 0;
    memcpy(needsParts, parts, sizeof(needsParts));
    needsKnown = true;
    portEXIT_CRITICAL(&needsMux);
    if (!same) needsDirty = true;
}

bool localTime(uint32_t& seconds) { return node.localTime(millis(), seconds); }

void sendRun(const hg::motion::Result& result) {
    const uint8_t frames = result.count ? result.count : 1;
    portENTER_CRITICAL(&runMux);
    for (uint8_t i = 0; i < frames; i++) {
        const uint8_t next = uint8_t((runHead + 1) % 8);
        if (next == runTail) break;
        proto::RunResult& rr = runRing[runHead];
        rr.run = uint8_t(result.run);
        rr.seq = result.seq & 0x0F;
        rr.index = i;
        rr.count = result.count;
        rr.aborted = result.aborted;
        rr.ms = result.count ? result.ms[i] : 0;
        rr.speed10 = result.count ? result.speed10[i] : 0;
        runHead = next;
    }
    portEXIT_CRITICAL(&runMux);
}

void requestAll(proto::Cmd cmd, uint8_t arg) {
    proto::Request rq;
    rq.cmd = cmd;
    rq.arg = arg;
    rq.all = true;
    portENTER_CRITICAL(&requestMux);
    const uint8_t next = uint8_t((requestHead + 1) % 4);
    if (next != requestTail) {
        requestRing[requestHead] = rq;
        requestHead = next;
    }
    portEXIT_CRITICAL(&requestMux);
}

void benchFace(int index) { faceRequest = index < 0 ? 0 : index; }
void benchBrightness(int level) { brightnessRequest = level; }
void benchIntro(const proto::Intro& intro) { onIntro(intro, nullptr); }
void benchLocalTime(uint32_t seconds) { node.setLocalTime(seconds, millis()); }

void reportImage(uint32_t crc) {
    portENTER_CRITICAL(&reportMux);
    const uint8_t next = uint8_t((reportHead + 1) % 16);
    if (next != reportTail) {
        reportRing[reportHead] = crc;
        reportHead = next;
    }
    portEXIT_CRITICAL(&reportMux);
}

void requestReboot() { reboot = true; }

bool takeIntro(proto::Intro& out) {
    if (!introPending.exchange(false)) return false;
    portENTER_CRITICAL(&introMux);
    out = introNow;
    portEXIT_CRITICAL(&introMux);
    return true;
}
uint32_t nodeId() { return currentNode; }
void setVbusMillivolts(uint16_t millivolts) { vbus = millivolts; }
uint32_t identifyUntilMs() { return identifyUntil; }
int takeBrightnessRequest() { return brightnessRequest.exchange(-1); }
int takeFaceRequest() { return faceRequest.exchange(-1); }
int takeDisplayRequest() { return displayRequest.exchange(-1); }
void setDemo(bool demo) { demoMode = demo; }
bool rebootRequested() { return reboot; }
bool takeHoldReset() { return holdReset.exchange(false); }

void themeColours(uint32_t out[32]) {
    portENTER_CRITICAL(&alertMux);
    memcpy(out, themeNow, sizeof(themeNow));
    portEXIT_CRITICAL(&alertMux);
}

bool alertMessage(char* text, uint32_t& color) {
    portENTER_CRITICAL(&alertMux);
    const bool show = alertNow.show;
    if (show) {
        memcpy(text, alertNow.text, sizeof(alertNow.text));
        color = alertNow.color;
    }
    portEXIT_CRITICAL(&alertMux);
    return show;
}

}  // namespace can_task
