jdennis011/haltech-gauges/src/gauge/can_task.h

#pragma once

#include <stdint.h>

#include "channel_store.h"
#include "drag_timer.h"
#include "proto.h"

// Owns the CAN controller. A dedicated task receives frames, decodes Haltech
// broadcast data into the channel store, and runs the gauge's side of the
// management protocol. Requests from the hub that affect the screen are left
// as flags for the UI loop to pick up.
namespace can_task {

void begin();

hg::ChannelStore& channels();
uint32_t framesReceived();
// The controller's counters, for the console's `can` command. state: 0 stopped,
// 1 running, 2 bus off, 3 recovering.
struct BusCounters {
    uint32_t frames;     // frames received on the wire
    uint32_t state;
    uint32_t tec, rec;   // transmit and receive error counters
    uint32_t busErrors;  // bit, stuff, CRC, form and acknowledge errors seen
    uint32_t rxMissed;   // frames lost to a full receive queue
    uint32_t txFailed;   // frames the controller gave up sending
};
BusCounters busCounters();
bool hubPresent();
uint32_t nodeId();

// Which link the live data is arriving on: CAN when Haltech frames came on the
// wire in the last second, else Wi-Fi when the IP link brought some, else none.
enum class LiveLink : uint8_t { None, Can, Wifi };
LiveLink liveLink(uint32_t nowMs);

// The Haltech frames the faces use (hg::cfg::framesUsed), told to the hub as
// proto::Needs so that it forwards only those (docs/frame-filter.md). Sent when
// it changes, when the hub appears, and every few seconds.
void setNeeds(const uint64_t parts[hg::proto::kNeedsParts]);

// A finished drag timer run (docs/motion.md): sent to the hub as RunResult
// frames, one per split reached. Dropped if the hub is away.
void sendRun(const hg::motion::Result& result);

// Reported to the hub in the status message.
void setVbusMillivolts(uint16_t millivolts);

// Identify: show this gauge's id until millis() reaches the returned time (0 = not requested).
uint32_t identifyUntilMs();
// Returns a brightness (0..255) the hub asked for, or -1 if there is none waiting.
int takeBrightnessRequest();
// A face index the hub asked for, or -1; a display request (0 off, 1 on), or -1.
int takeFaceRequest();
int takeDisplayRequest();
// The hub asked for the held peaks and minimums to be cleared; true once per request.
bool takeHoldReset();
// The key-on intro the hub asked for, or a replay from the page; false if none is waiting.
bool takeIntro(hg::proto::Intro& out);

// The hub's time of day as seconds since 1970 in its zone, kept running from
// its last beacon; false if no hub has ever said (docs/time-of-day.md).
bool localTime(uint32_t& seconds);

// From the pull-down menu: ask the hub to apply a setting to every gauge.
void requestAll(hg::proto::Cmd cmd, uint8_t arg);

// --- from the serial console, for a gauge on the bench with no hub
void benchFace(int index);
void benchBrightness(int level);
void benchIntro(const hg::proto::Intro& intro);
void benchLocalTime(uint32_t seconds);

// --- from the Wi-Fi task
// An image fetched over Wi-Fi is now stored: the hub is told from the CAN task.
void reportImage(uint32_t crc);
// Restart once the bus has settled (after a firmware install).
void requestReboot();
bool rebootRequested();
// Whether the faces are showing the demo sweep, for the status message.
void setDemo(bool demo);

// The alert message the hub wants shown over the face. False when there is
// none; otherwise fills `text` (at least 33 bytes) and `color` (0xRRGGBB).
bool alertMessage(char* text, uint32_t& color);

// The hub's 32 theme colour slots (0xRRGGBB), for resolving "themecolour1" to 32
// in a face. The last ones the hub sent are kept in flash for running without a hub.
void themeColours(uint32_t out[32]);

}  // namespace can_task
