jdennis011/haltech-gauges/(commit log)

2026-10-03 Haltech CAN gauge system: hub and gauge firmware, web UI, hardware spec
    Hub (ESP32-C6, C3 for development): CAN bridge, management protocol, config
    library and push, Wi-Fi AP/station, web page with planned gauges, live data,
    config editor with previews, fifteen starter templates and five fonts.
    Gauge (Waveshare ESP32-S3 AMOLED, M5Stack Dial on the bench): board bring-up,
    display, touch, CAN, config parser shared with the hub, native tests.
    Docs: web UI and API, config schema, templates, electrical spec, BOMs,
    bring-up checklist, PCBWay BOMs, Eagle schematics, designer plan.
    [gauge-adapter-bom.csv, gauge-adapter.sch, gauge_16MB.csv, hub-carrier-bom.csv, hub-carrier.sch]
2026-10-03 Style panel: colour, rotation, alignment and show-unit for every widget
    Colour pickers offer the theme roles or a custom colour, for the widget, its
    needle, track, or lit and off states. Rotation now applies to numbers, lights
    and bars as well as labels, in the parser and the preview; arcs expose their
    start angle. Text widgets get alignment; numbers get a show-unit checkbox and
    unit placement.
2026-10-03 Editor: Add widget button and per-widget remove
    A type picker and button put a new widget on the current face with sensible
    defaults, selected and ready to drag; each row in the style panel has a
    remove button. The parser's 16-per-face limit is enforced in the page.
2026-10-03 Simulator: pause, speed, and per-channel hold or min..max overrides
    The values follow their own clock, which the page can pause or run at
    0.1x to 4x; frames keep going out so gauges hold frozen values. Up to 16
    channels can be held at a value or swept between chosen limits, in the
    channel's stored unit. GET/POST /api/simulator carry the settings, the
    status reports them, and the Live data tab has a Simulator card. The online
    copy's demo does the same and remembers it.
2026-10-03 Screen on/off and all-gauges brightness; gauge pull-down menu designed
    Protocol: Cmd::SetDisplay and a gauge-to-hub Request {cmd, arg, all} with
    GaugeNode::request(). HubManager gains online and request callbacks. The
    hub's display_control keeps the all-gauges brightness in preferences and the
    screens-off state in RAM, re-applies both to gauges that come online, and
    serves /api/gauges/all/{brightness,display,identify} and per-gauge display.
    The page gets an All gauges strip and per-card screen buttons. The gauge's
    own pull-down panel is written up in docs/gauge-quick-menu.md.
2026-10-04 Online copy: Sign in with Google and per-account storage
    The Worker verifies Google ID tokens against Google's keys, keeps a signed
    session cookie, and stores a signed-in user's configs, planned gauges,
    assignments and recordings in KV behind the hub's own API paths, with a
    hand-kept index so saves show at once. The page shows the sign-in button
    when a client ID is configured, routes those paths to the account while
    signed in, offers to copy local work into a fresh account, and otherwise
    keeps working from the browser.
2026-10-04 Alerts: rules on the hub that put a message on the gauges or switch their face
    A rule watches one channel: above or below a value, outside or inside a
    range, a flag on or off, or any change. While it holds, the gauges it is
    aimed at show its message, switch to its face, or both, and go back when
    it ends. Rules have a delay before firing and a hold time after, live in
    /alerts.json on the hub, and are checked ten times a second.
    - lib/hg_alerts: rule format, parser, evaluation, and the dispatcher that
    carries alerts out on the roster, with host tests
    - protocol: Alert message (type 6), a header and up to five text frames,
    repeated while in force so a lost clear cannot leave a message up
    -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
2026-10-04 Second hub schematic: carrier for an ESP32-P4 board with Wi-Fi module, clock and GPS header
    hardware/hub-carrier-p4.sch, generated by scripts/gen_eagle_sch.py, is the
    hub on an Olimex ESP32-P4-DevKit. The 12 V input, 5 V rail, CAN transceivers
    and connectors are the C6 carrier's. Added on the carrier:
    - an ESP32-C6-MINI-1 as the Wi-Fi radio, over SDIO on the pins Espressif's
    own P4 board uses, with its serial port, boot and reset wired to the P4 so
    the P4 can load its firmware
    - a DS3231 real-time clock with a 2032 cell and a jumpered trickle charger
    for a rechargeable ML2032
    - an optional five-pin GPS header with selectable 3.3 V or 5 V supply
    - the DevKit fed through its POE_PWR1 in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
    [hub-carrier-p4-bom.csv, hub-carrier-p4.sch]
2026-10-04 P4 hub carrier on the Waveshare ESP32-P4-WIFI6, with an Adafruit GPS and external antenna
    The second hub schematic moves from the Olimex ESP32-P4-DevKit to the
    Waveshare ESP32-P4-WIFI6 (SKU 32020), which carries its own ESP32-C6
    Wi-Fi. The carrier loses its Wi-Fi module, the SDIO pull-ups, the C6
    programming lines and the POE_PWR1 lead:
    - the board's 5 V goes into VSYS through D3, as on the C6 carrier;
    VBUS (its USB 5 V) is left unconnected
    - CAN, 12 V sense and the clock's I2C stay on the same GPIOs; the
    clock's 1 Hz line moves to GPIO31
    - J12 is now a 9-way socket for the Adafruit Ultimate GPS (product
    746), with standoff holes from Adafruit's board file and an external
    active ant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
    [hub-carrier-p4-bom.csv, hub-carrier-p4.sch]
2026-10-05 Theme colours: eight colours kept on the hub and shared by every config and gauge
    A config can now use "themecolour1" to "themecolour8" (or "themecolor")
    anywhere a colour goes, including a role in its own theme object. The
    hub keeps the eight colours and their names in /theme-colours.json;
    change one and every widget using it changes with it, on every face of
    every gauge, without pushing a config again.
    - format: the parser keeps theme colour references, resolveColor()
    looks them up at draw time; parseThemeColours() for the hub's list
    - bus: ThemeColours message (type 7), four self-contained frames, sent
    when the colours change, to a gauge that comes online, and every 10 s;
    the gauge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
    [can_task.cpp, can_task.h, main.cpp, test_main.cpp, theme_colours.cpp, theme_colours.h, web_server.cpp]
2026-10-05 Theme colours: add your own, up to 32
    The hub now keeps 8 to 32 theme colours instead of a fixed eight.
    "Add colour" on the Theme colours card appends one (with a suggested
    colour to start from), and only the last can be removed, so
    themecolourN always means the same slot and no config is renumbered.
    The first eight always stay.
    - format: themecolour1 to themecolour32; a number the hub does not
    have is drawn white, on the gauge and in the previews, and a widget's
    colour list still shows it as "theme N (not on this hub)"
    - bus: the ThemeColours message carries all 32 slots in sixteen
    frames, unused ones white, so every gauge matches the hub exactly
    - hub, page, demo, account storage an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
    [can_task.cpp, can_task.h, test_main.cpp, theme_colours.cpp, theme_colours.h]
2026-10-05 Colour wheel for the theme colours on the Gauges tab
    A "Theme colours" section on the Gauges tab, folded away until opened
    (the page remembers which), changes one shared colour at a time: a
    dropdown of the theme colours, a hue and saturation wheel with a
    brightness slider, a swatch and a hex box. The previews follow as the
    wheel moves; the hub gets the colour at most twice a second while
    dragging and once more on letting go, so the gauges follow without a
    flash write for every mouse movement. The wheel snaps to full colour at
    the rim and to white in the middle.
2026-10-05 Gauge cards stacked top to bottom
    Each card on the Gauges tab now reads down the card: name and status,
    details, a larger centred preview (240 px), then Config, Face and
    Brightness as labelled rows that use the full width, the sync state
    with Edit config, and the action buttons. The preview no longer sits
    beside the controls, so the config list stays inside the card.
2026-10-06 Images for the faces: kept on the hub, sent to each gauge over the gauge bus
    JPEG and PNG files (up to 466 x 466, 256 KB) in a library on the hub, used
    by name in configs: an image widget (fit contain, cover or stretch, opacity,
    rotate, optionally shown only while a channel's condition holds) and a face
    background (bgImage, bgImageOpacity).
    Each gauge gets the images its config uses before the config, once. Images
    are named by the CRC32 of their bytes: the hub adds an "images" map to the
    config on its way to the gauge, asks the gauge whether it has each one
    (new message Asset, type 14) and sends only what is missing (transfer kind
    Image), read from flash a block at a time. The gauge keeps t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
    [can_task.cpp, image_store.cpp, image_store.h, library_store.cpp, library_store.h, main.cpp, test_main.cpp]
2026-10-15 P4 hub, cloud sync with the online account, gauge face renderer, rev B adapter
    Hub on the Waveshare ESP32-P4-WIFI6: env hub_p4 (rev 3 chip, 32 MB flash,
    23 MB LittleFS, console on the CH343 UART), the P4 pin map from the carrier
    spec, Wi-Fi through the board's ESP32-C6 as shipped. Two one-off envs for the
    C6's firmware: hub_p4_c6update (over SDIO; the factory firmware refuses it)
    and hub_p4_c6bridge (the P4 as a serial bridge to the C6's header).
    Cloud sync: a hub links to an account on oagauge.online with a six-character
    code from the site and from then on keeps configs, images, theme colours and
    alerts in step both ways, over HTTPS verified against the core's root bundle.
    The hub polls a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
2026-10-15 Alerts can switch a gauge to another config; images and paths in the renderer
    Alerts: a rule's new `config` key names a library config the gauge shows in
    place of its own while the alert holds, with `face` counting within it. The
    hub sends it like "try on gauge" as a new transfer kind, SwitchConfig (4):
    images first, RAM only, no trial note on the gauge; EndTry and the earlier
    face come back when the alert ends. The dispatcher tracks each gauge's switch
    (landed, retry after 2.5 s without a status, never more often than 3 s, waits
    for an in-flight transfer before ending) through a ConfigSource callback that
    the hub answers from the library, loading the config into RAM on first use.
    Page: conf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
2026-10-17 Firmware updates, start-up intro, Wi-Fi transfers, time of day, Wi-Fi gauge link
    Hub firmware updates over Wi-Fi (6h): scripts/release_fw.ps1 builds every
    board and publishes firmware.bin + manifest.json to the site's KV; the Worker
    serves /fw/<board>/; the hub checks daily, the page shows and installs the
    build (download into the spare slot, SHA-256 checked, restart, rollback by the
    bootloader unless confirmed after 10 s), and takes a .bin upload. Gauge builds
    are fetched onto the hub and passed to a gauge over Wi-Fi with a token.
    Start-up intro (6b): Cmd::Intro in a command frame (style, delay, duration,
    slot, count); the hub waits for the gauges it expects, then sends each its
    slot in th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
2026-10-17 Gauge pull-down menu, SD card datalog on the P4 hub
    Gauge (6c): a swipe down opens a panel over the face with a brightness
    slider (live, saved to flash on release), Screen off, and this/all scope;
    "all" goes to the hub as a Request. Swipe up, a tap outside or five seconds
    closes it. A dark screen is not drawn and its first touch only wakes it.
    Hub (6i): with a microSD card in the P4's slot, every drive is logged as CSV,
    every channel ten times a second, a file per key-on named by the clock,
    flushed each second, rotated at 64 MB; a Settings card lists, downloads and
    deletes logs, with a logging switch kept in preferences.
    The card is brought up with the chip's SD driver directly rather than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
2026-10-17 Designer polish: multi-select, undo/redo, zoom, drafts, keys overlay
    The page editor gains undo and redo (Ctrl+Z/Y and buttons, one step per
    change or typing burst, 100 deep), multi-select (shift+click, Ctrl+A;
    the set drags and nudges together, Delete removes it, Ctrl+D duplicates
    it, Same x/y and Spread x/y line it up), a Zoom choice for the preview,
    drafts kept in the browser and offered back when a config is reopened,
    and a ? overlay listing the keys. Hub 0.3.6 carries the page; the site
    is deployed.
    docs/firmware-updates.md: an uploaded .bin must be sent as
    application/octet-stream; a form content type makes the web server
    collect the body as fields until the heap runs out.
    Co-Authore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
2026-10-26 Steering wheel module, simulator presets, gauge 0.1.3, hub 0.3.14
    Steering wheel (phase 6j, docs/steering-wheel.md): Msg::Input and
    Cmd::InputRaw in the protocol, lib/hg_wheel (controller with horn
    fail-safe, FG cruise frame table), the wheel env for a Lolin C3 Mini
    (ladder buttons, CAN link, Wi-Fi firmware fetch, console), hub side
    with a third CAN port on the P4, horn and SWC outputs, /api/wheel and
    the Wheel card, wheel-c3 on the release script; gauge-only predicates
    in the intro, alerts, display control and theme colour paths; 15 wheel
    tests and six system tests with a simulated wheel.
    Gauge 0.1.3: needle-only invalidation, QSPI 80 MHz, LVGL pool in PSRAM,
    images decoded once; quick men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
2026-10-28 Gauge speaker and alert sounds, rev B carrier schematic, JLCPCB, FG test build
    Gauge 0.1.5: the Waveshare board's ES8311 codec and speaker amplifier are
    driven (src/gauge/audio_waveshare.cpp: I2S 16 kHz, tones from a player
    task, amplifier on only while playing). Identify chimes; the console takes
    tone, chime and volume; PlaySound and SetVolume commands; the volume rides
    in the Status flags so the hub knows which gauges have a speaker.
    Hub 0.3.15: alert rules take `sound` (beep, chime, alarm) and `repeat`;
    the dispatcher plays a sound when a rule comes into force for a gauge and
    again every `repeat` seconds, without replaying what was already in force
    to a gauge that has just appeared. Volu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
2026-10-28 Riff sound (gauge 0.1.6, hub 0.3.16) and carrier rev A bring-up notes
    - proto::Sound::Riff (4): the seven notes of the guitar tab, two octaves up for the
    small speaker; accepted as "riff" by alert rules, the sound API and the page, with a
    Riff button on the gauge card and `play N` on the gauge console
    - audio queue widened to 32 notes; built-in sounds table in docs/gauge-audio.md
    - bring-up checklist: step 5 (first Haltech connection, engine off) and the 2026-10-28
    result (carrier rev A running with the Pololu on jumper wires; DS3231 found; the
    gauge-bus error counter with nothing on the wire)
2026-10-28 Hub 0.3.17: gauge-bus received count and TEC/REC on the Settings card
    - /api/status bus: frames received on the wire, rejected writes, tec, rec;
    ecu: tec, rec. The Settings rows show them with the error counts.
    - Bring-up checklist: the first gauge on the chain from the carrier (power
    readings, the CAN link that did not come up, and how TEC 128 with nothing
    received pins the fault to the adapter's transceiver).
2026-10-29 Gauge 0.1.7: CAN pins match the real header, and a can console command
    The first chain test failed because the gauge drove CAN transmit on GPIO17
    and listened on GPIO18, following Waveshare's hardware reference. Traced
    with a meter, the rear header has position 6 = GPIO16 and 7 = GPIO17, so the
    transceiver's D input hung on an undriven pin and its R output fought the
    transmit output. board_pins.h now has transmit on 16 and receive on 17; the
    link came up at once (hub TEC 0, REC 0, gauge receiving the simulator).
    The console gains `can`: controller state, frames received, TEC, REC, bus
    errors, missed and failed frames, whether the hub is heard, and the link.
    Spec 2.1 and 2.2 record the meas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
2026-10-29 Checklist: chain power is clean, the error bursts were the bench USB ground
    Sixty seconds on chain power with the simulator at full rate: one bus
    error, TEC and REC at zero. Notes the cumulative error counter and the
    open dual-link point (roster says wifi, management frames arrive twice).
2026-10-29 Checklist: two gauges on the chain, both on 0.1.7, bus clean
    D029F0 updated from the site through the card; two status frames a
    second on CAN, zero errors over 30 s, TEC and REC at zero.
2026-10-29 Gauge 0.1.9, hub 0.3.19: peak/min hold with Reset peaks, and the oaGauge boot splash
    Peak and minimum hold (gauge 0.1.8, hub 0.3.18/0.3.19): `hold` (max/min),
    `holdColor` and `holdSeconds` on dial, ring, bar and number. Dials draw a thin
    tell-tale needle at the held value, rings and bars a line across the track, a
    number shows the held value. Only live readings are held (not the demo sweep
    or the intro); holds survive a face switch but not a new config; a timed hold
    rolls back to the live value once the peak is older than holdSeconds. Reset
    peaks on the pull-down menu for this gauge or all (Cmd::ResetHold = 12, relayed
    by the hub), on the gauge card and the All gauges strip
    (/api/gauges/{nod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
2026-10-30 Gauge 0.1.10, hub 0.3.20: link icon on the gauge, and the hub forwards only the frames in use
    Gauge: a Wi-Fi fan or a CAN plug drawn with LVGL shapes (src/gauge/link_icon.cpp),
    always on the pull-down menu with its name, and on the face for three seconds when
    the live-data link changes. can_task::liveLink() picks CAN when a Haltech frame came
    off the wire in the last second, else the IP link.
    Frame filter (docs/frame-filter.md): after building a face the gauge sends the frames
    its widgets use as a Needs message (Cmd::Needs = 13 as a gauge-to-hub Command, two
    parts of 40 bits by frame-table index plus a table tag). The hub keeps each online
    gauge's list and forwards the union from the ECU br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
2026-10-31 Gauge 0.1.11, hub 0.3.21: G meter from the gauge accelerometer, and a drag timer
    Gauge: the QMI8658 on the Waveshare 1.75 is read every 20 ms from the UI loop
    (src/gauge/imu_waveshare.cpp); two captures on the pull-down, Set level at rest
    and Set forward while braking, give up and forward for any mounting (kept in
    flash). A gmeter widget draws the dot on crosshair rings with a fading trail,
    peak marks and the numbers; a dragtimer widget times 0-100, the strip's splits
    with the trap speed, and the rolling 80-120 and 100-200 runs from the vehicle
    speed, the accelerometer bringing the start forward, with rollout, lift and
    stale-data rules (lib/hg_motion, host-tested on made-up traces). Timers r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
2026-11-05 Gauge 0.1.12: built-in drag timer overlay on a pull up from the bottom edge
    Every gauge gets a drag timer without one in its config: a pull up shows it over
    the face, swipes left and right pick the run type, a swipe up brings the face
    back. Nothing of it runs until the first pull.
2026-11-08 Hub 0.3.23: format the SD card from the page
    The hub's FatFs is built without exFAT and with 32-bit sector numbers, so it
    reads FAT only; big cards come exFAT and Windows will not make FAT32 over
    32 GB. Settings > SD card now offers Format as FAT32 or FAT16: the hub says
    first what the card gets (the whole card, or one partition of the most the
    filesystem can address, the rest left unused), then the word FORMAT must be
    typed. The format runs on the log's task: f_fdisk for the partition, f_mkfs
    on it, label OAGAUGE, then the usual mount and write/read self-test.
    - lib/hg_sd/format_plan.h: planner (FAT32 cap 2 TiB, FAT16 cap 4 GB, minimums), test_native_sd
    - sd_card: present(), plan(), format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
